TBock3185/CraftCube/Second Semester/Business Proposal/20161115_212312.jpg

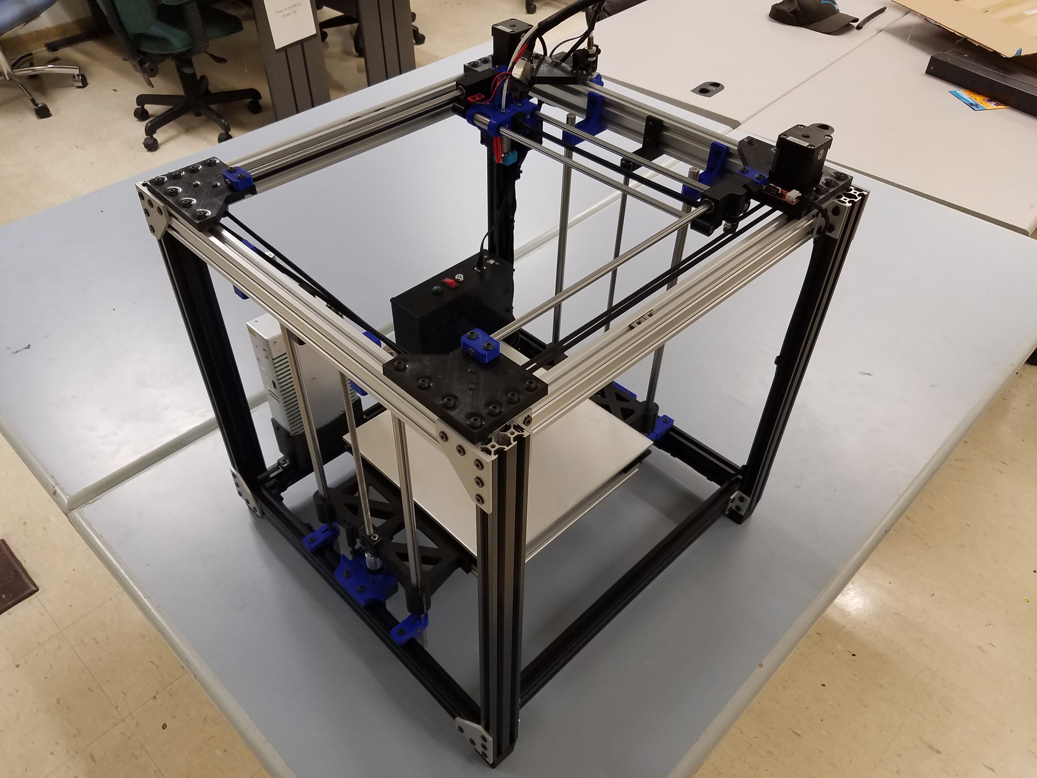
Second Semester/Business Proposal/20161115_212312.jpg
