TBock3185/CraftCube/Second Semester/193B Final Poster Draft/20161204_013916.jpg

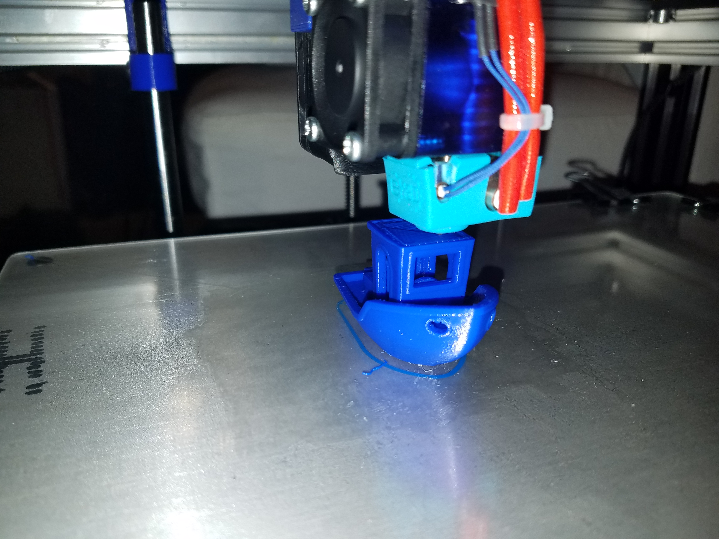
Second Semester/193B Final Poster Draft/20161204_013916.jpg
