TBock3185/CraftCube/README.md

# CraftCube
This is a repository for my  CSUS 2016 Senior Project, the Craft Cube -- CNC Laser Engraver/ 3D Printer 

Video Timelapses for Final Demonstration:

 3D Printing Timelapse: https://www.youtube.com/watch?v=elfPQdwai-g

Laser Engraving Timelapse: https://www.youtube.com/watch?v=zEBCX6oA3y4
