TBock3185/CraftCube/3D CAD Files/README.md

This readme is to note that the CAD files are incomplete because I did not include several parts:

-Pretty much all nuts & bolts

-Extruder

-Raspberry Pi Touchscreen

-Probably other stuff...

Hopefully in the coming days I will work out a BOM List.
