TBock3185/CraftCube/Second Semester/193B Final Poster Draft/193Poster_Draft _2.docx

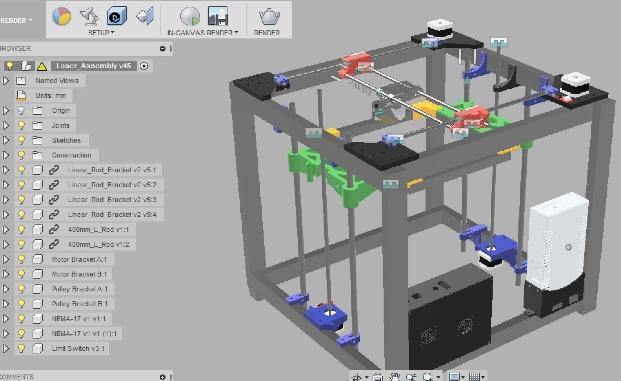
[picture p3: figure]

# Design Craft Cube Software

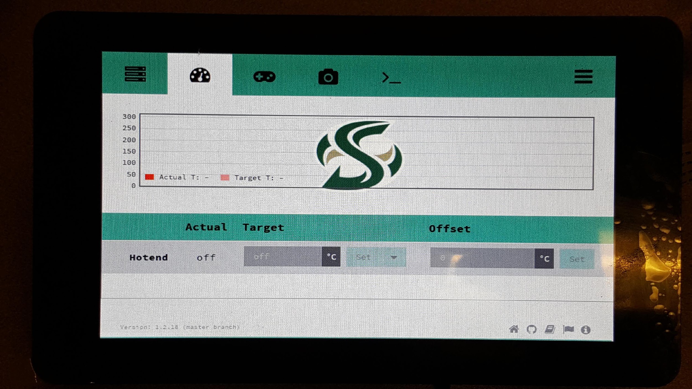
[picture p4: figure]
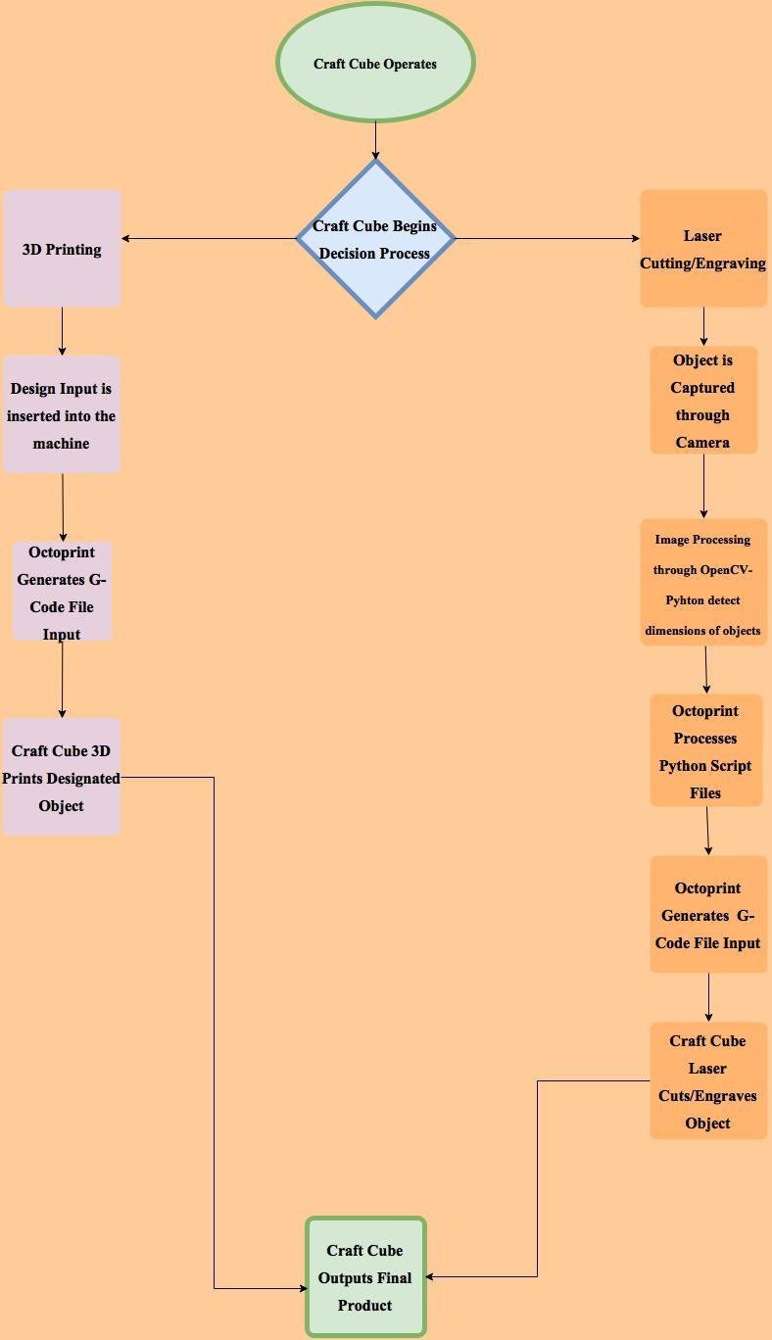
[picture p5: figure]

Craft Cube is a low cost 2 in 1 CNC machine utilizing a user-friendly operating system.

3D Model Management System

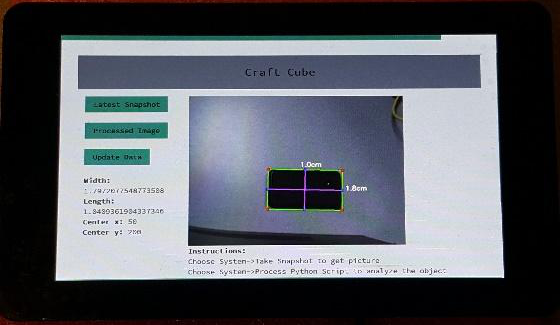
[picture p6: figure]
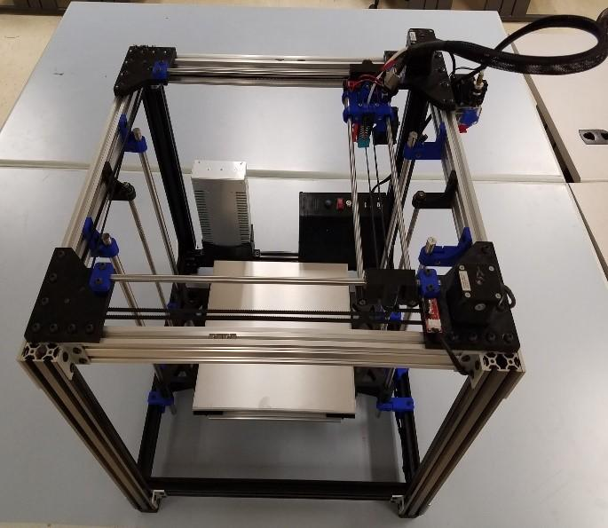
[picture p7: figure]

Flowchart

Detection Camera

CRAFT CUBE
