TBock3185/CraftCube/Second Semester/193B Final Poster Draft/V2.pptx

## Craft Cube

- 2 in 1 CNC Machine

Ammar Ahmed, Thomas Bock, Michael Gomez, Tan Hua
Electrical and Electronic Engineering, California State University Sacramento

- Hardware

Craft cube is a low cost 2 in 1 CNC Machine utilizing a user-friendly operating system. The design of the machine is constructed through 3D-Printed Parts available online. A Camera aide mounted on the end effector is used for image processing algorithm to determine the dimensions of the object.

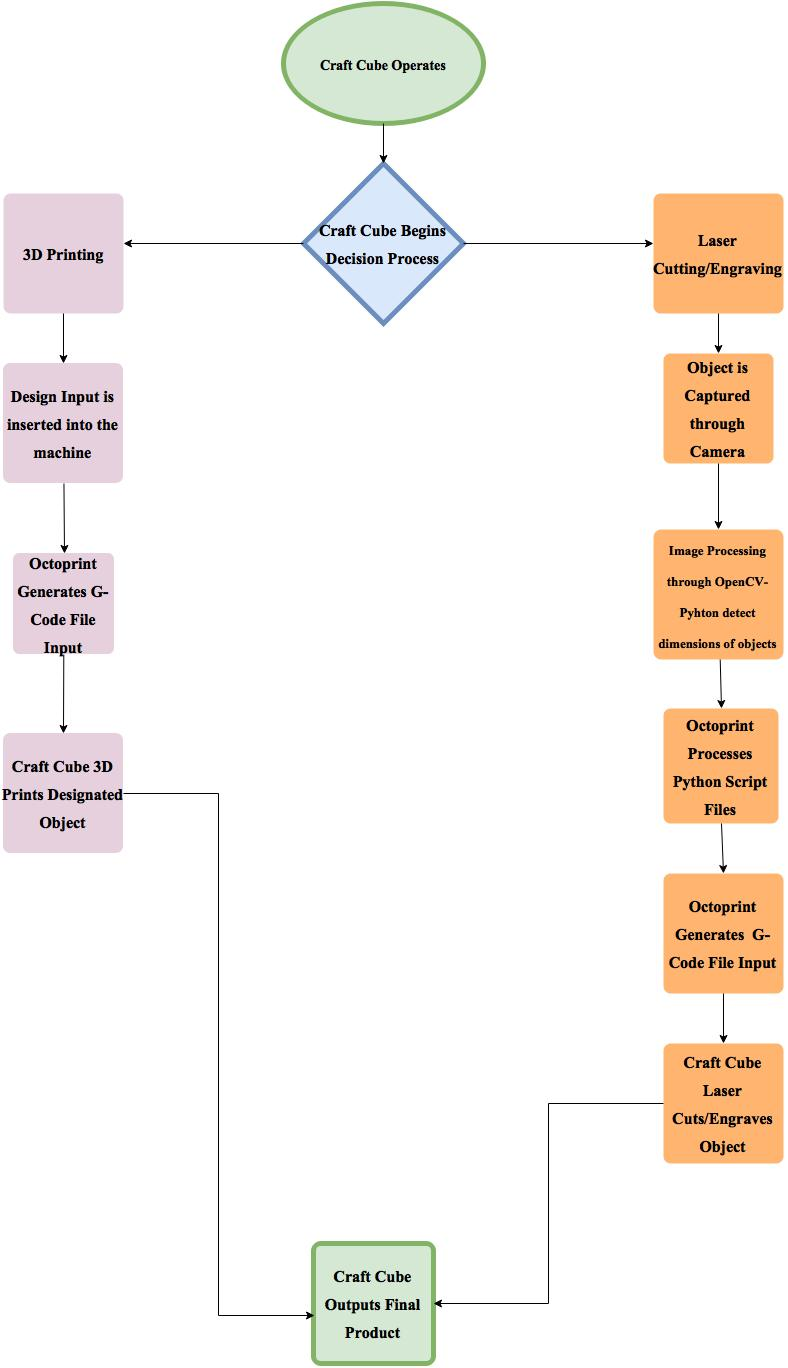
[picture p9: figure]

- 3D Model

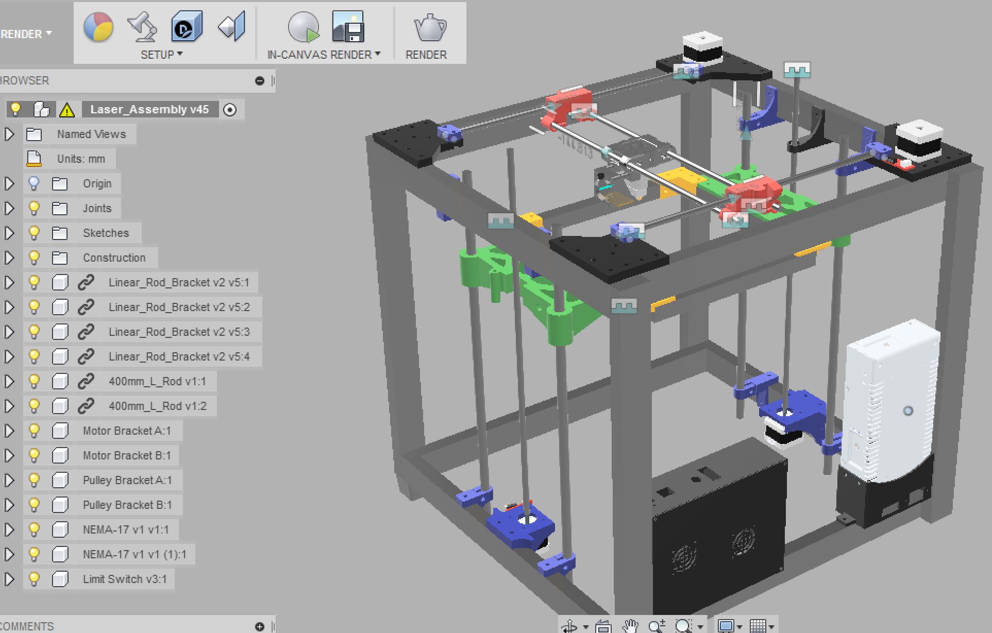
[picture p10: figure]

- 3D Print

- Hardware

Management

- Camera system

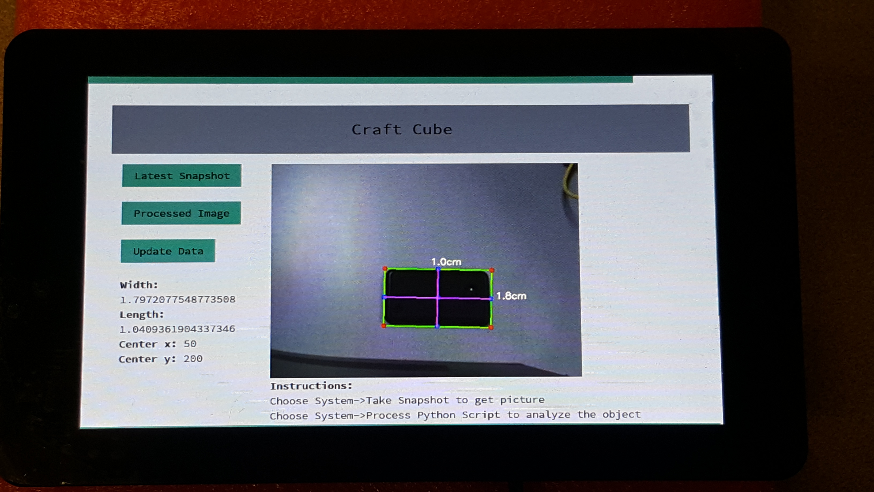
[picture p11: figure]

Laser Cutter/Engraver
