TBock3185/CraftCube/Second Semester/Business Proposal/milestone.docx

Projected Milestone

8

6

4

2

Months

Partnership

Final Version

Machine V1

Machine V2

Prototype
