TBock3185/CraftCube/Second Semester/Week 10/SeniorProjectProgress_WeeklyReport.docx

Team Members:

- Thomas Bock
- Ammar Ahmed
- Tan Hua
- Jan Michael Golez

Group Meeting Minutes:

● CNC Laser Machine Part Remodeled Version2

● Raspi Camera Image Detection

● Open CV through Python, and Octorpint Set-up

Summary of Team Tasks Assigned:

1. Housing/Ventilation System
  a. Examine Parts Needed for Ventilation System(e.g. cost of materials)
2. Stand Alone Management System(S.A.M.S.)
  a. Octoprint Troubleshooting Issues needs to be resolved
  b. Begin Testing Octoprint
3. Solitary Software System
  a. Research the necessary software package that can be read in RasPi3
  b. Understand how to connect a bridge between the software with the automated camera aspect.
4. Automated/Enhance Camera System
  a. Begin Researching on OpenCV-Python
  b. Research on different microcontrollers that is compatible with OpenCV-Python

Summary of Team Accomplishments:

1. Housing/Ventilation System
a) Parts have been examine, a group consent is required to further proceed with the materials
2. Stand Alone Management System
a) Update Raspbian to ensure Octoprint is working
b) Test and Update all software
3. Solitary Software Program
a) Python found most compatible between software, management system, and camera system
b) Begin Transcripting the language into Python
4. Automation/Enhance Camera System
a) Research on OpenCV-Python and installation of the software and libraries needed
b) Raspberry Pi3 was found to be the most compatible for making a connection between camera system and management system

Tasks Assigned for Next reporting period:

1. Housing/Ventilation System
a) Proceed discussion with parts and began redesigning enclosure/ventilation system
2. Stand Alone Management System
a) Test Octoprint with given generated Python Code
b) Have a printed structure
3. Solitary Software Program
a) Continue to transcript language into Python
b) Help with bridging management sytem, Camera, and Software
4. Automation/Enhance Camera System
a) Purchase RasPi3
b) Install OpenCV-Python in RasPi3

Issues:

1. Troubleshooting SD Card upon switching different cards

Individual Summary (cont.)

Name: Thomas Bock

Tasks Assigned for this reporting period:

1. Examine Parts Needed for Ventilation System(e.g. cost of materials)

Accomplishments this reporting period:

1. Parts Examined for enhancement of Prototype CNC Machine

Issues:

1. None

Tasks Assigned for Next reporting period:

1. First Draft Design of Ventilation/Enclosure

Individual Summary (cont.)

Name: Jan Michael Golez

Tasks Assigned for this reporting period:

1. Octoprint Troubleshooting Issues needs to be resolved

2. Test Octoprint

Accomplishments this reporting period:

1. Update Raspbian to ensure Octoprint works

2. Test and Update all software

Issues:

1. Resolving issue with Raspbian to download image.

2.

Tasks Assigned for Next reporting period:

1. Test Octoprint with given generated Python Code

2. Have a printed structure

Individual Summary (cont.)

Name: Tan Hua

Tasks Assigned for this reporting period:

1. Research the necessary software package that can be read in RasPi3
2. Understand how to connect a bridge between the software and the automated camera aspect.

Accomplishments this reporting period:

1. Python found most compatible between software, management system, and camera system
2. Begin Transcripting the language into Python

Issues:

1. None

Tasks Assigned for Next reporting period:

1. Continue to transcript language into Python
2. Help with bridging Management System, Camera, and Software

Individual Summary (cont.)

Name: Ammar Ahmed

Tasks Assigned for this reporting period:

1. Continue calibrating camera
2. Start on image processing algorithm to detect object.

Accomplishments this reporting period:

1. Camera calibration was accomplished and extrinsic and intrinsic matrix of the camera parameters has been extracted.
2. The image processing algorithm is in progress. At the mean time, the code is able to capture image, transform image into binary, and perform edge detection and some noise filtration.

Issues:

1. The extrinsic and intrinsic parameters of the camera might not be accurate. This could be resolved by mounting the camera at fixed point and taking several pictures of the checkerboard for calibration.

Tasks Assigned for Next reporting period:

1. Continue on image processing algorithm to detect object.

EEE 193B / CpE 191 Group 3S Weekly Progress Report Date: 10/31/16
