TBock3185/CraftCube/First Semester/Final Report/FinalReport.docx

California State University Sacramento

Electrical and Computer Science Department

EEE 193A/CPE 190 - Product Design Project I

Final Project Report

CNC Laser Cutter and Engraver


Team Member: Ammar Ahmed/Thomas Bock/Tan Hua/ Michael Golez

INSTRUCTOR: Suresh Vadhva

Abstract –

Keywords:

# I. Design Overview

## A. Introduction

In the industry, a widely used component for cutting and engraving materials is a CNC laser cutting machine. The machine operates by using a high-energy infra-red laser light beam. A focusing lens is attached to the laser in order to concentrate the energy into single focal point, thereby vaporizing and melting the material of interest. In order to alter the position of the laser into a desired location, a computer program known as CNC drives the positon of both the x and y axes. Asides the orientation of the axes, CNC codes can adjust the intensity of the laser to optimized the speed of the engraving or cutting of the material. Finally, by using machine vision, through the process of object orientation we can determine the position of the material. This process allows alteration of the material for better result, so that during the process the engraving or cutting is accurately done. The creation of the CNC Laser Machine will be conducted into four different parts: the mechanics between the positions of the CORE x-y axes, the laser machine circuit, CNC software for control and intensity, and finally detection system.

## B. Equipment List

A. Mechanical Parts:
  a. Stepper Motor (x2):
  b. Belts
  c. Rods
  d. 3D Printed Parts:
    i. Mounting….
B. Laser System:
  a. Laser Diode:
  b. Laser Driver:
C. Computer Vision:
  a. Web Cam (x1): Logitech C270 720p 3-MP
D. Microcontroller:
E. Arduino Shield:

## C. Team Member Summary

## D. Detailed Description

### a. Mechanics

### b. Laser System

### c. Software

### d. Computer Vision

# II. Proposals

## A. Funding Proposal

## B. Product Proposal

# III. Work Breakdown Structure (WBS)

## A. Outline of WBS

### Mechanics

### Laser System

### Software

### Computer Vision

## B. Project Timeline

### Milestone I

### Milestone II

### Milestone III

# IV. Risk Assessment

### A. Laser

### B. Mechanics

# V. User Manual

### A. Operation

- Safety considerations: Room Requirement, Objects to be cut/Engrave, Goggles

### B. Hardware Requirements

- Laptop: MATLAB, Inkscape
- Power Supply
- On/Off switch

### C. Software Requirements

- MATLAB, INKSCAPE, ReplicatorG

# VI. Design Documentation

# VII. Breakdown of Hardware Subsystems

### A. Camera

### B. Laser Diode

### C. Arduino

### D. Block diagram

# VIII. Breakdown of Software Subsystems

### A. Object Detection Algorithm

### B. Generating of G-Code

### C. Laser control

### D. Flow Chart

# IX. Mechanical Drawings and Documentation

# X. Test Plan for Hardware

# XI. Test Plan for Software

# XII. Integration Plans

# XIII. Accomplishment

# XIV. Conclusion

# XV. Appendix A: References

# XVI. Appendix B: Code

CSUS- EEE 193A/CPE 190 Final Report: CNC Laser Cutter and Engraver Ahmed/Bock/Hua/Golez
