TBock3185/CraftCube/First Semester/Week 15/SeniorProjectProgress_WeeklyReport.docx

Team Members: Thomas Bock, Ammar Ahmed, Tan Hua, Jan Michael Golez

Group Meeting Minutes:

- Testing CNC Laser.
- Attach Camera
- Complete Software Integration
- Documentation Discussed
- Assign parts that are towards each member
- Talk For Future Plans toward the project

Summary of Team Tasks Assigned:

1. Mechanics
a. Attach LED on rail boards.
2. Laser Diode
  a. Continue Documentation
3. Software
a. Begin Documentation.
4. Computer Vision
  a. Work on algorithm for edge detection( needed for dimension detection)

Summary of Team Accomplishments:

1. Mechanics
a. Camera System Attached
2. Laser Diode
a. Attach LEDS on the CNC laser to remove shadow effects.
b. Continue Documentation
3. Software
a. Rasterizing works 25%.
4. Computer Vision
a. An algorithm was found for filling circular objects but still working on the drawing box around the detected object.

Tasks Assigned for Next reporting period:

1. Mechanics
  a. Ensure that the device is Functional
  b. Begin Documentation
2. Laser Diode
a. Extend Wire connection for LEDS.
3. Software
a. Continue documentation.
b. First Draft Done
4. Computer Vision
  a. Resolve the issue by finding the algorithm for filling the gaps or drawing a box around the detected object

Issues:

1. Test Laser was misplaced or lost, discussion whether new laser will be bought or detaching the laser from the project itself.
2. None

Individual Summary (cont.)

Name: Thomas Bock

Tasks Assigned for this reporting period:

1. Attach LED on rail boards.

Accomplishments this reporting period:

1. Camera System Attached .

Issues:

1. Rasterizing works only a portion of the time.

Tasks Assigned for Next reporting period:

1. Ensure that the device is Functional
2. Begin Documentation

Individual Summary (cont.)

Name: Jan Michael Golez

Tasks Assigned for this reporting period:

1. Continue Documentation

Accomplishments this reporting period:

1. Attach LEDS on the CNC laser to remove shadow effects.
2. Continue Documentation

Issues:

1. None

Tasks Assigned for Next reporting period:

1. Extend Wire connection for LEDS.

Individual Summary (cont.)

Name: Tan Hua

Tasks Assigned for this reporting period:

1. Begin Documentation

Accomplishments this reporting period:

1. Rasterizing works 25%.

Issues:

1. Rasterizing works only a portion of the time.

Tasks Assigned for Next reporting period:

1. Continue documentation.
2. First Draft Done

Individual Summary (cont.)

Name: Ammar Ahmed

Tasks Assigned for this reporting period:

1. Finishing up with documentation
2. Preparing final presentation slides

Accomplishments this reporting period:

1. Documentation started and on progress
2. Presentation Slides almost done

Issues:

1. No issues found

Tasks Assigned for Next reporting period:

1. Finishing up with documentation
2. Preparing final presentation slides

EEE 193A / CpE 190 Group 3S Weekly Progress Report Date: 5/9/16
