TBock3185/CraftCube/First Semester/Week 10/EEE 193A Design Review.docx

CNC Laser Cutting Machine

Ammar Ahmed, Thomas Bock, Tan Hua and Michael Golez
California State University, Sacramento

EEE-193A/CPE 190
2330-2016

Abstract –

# I. Introduction

In the industry, a widely used component for cutting and engraving materials is a CNC laser cutting machine. The machine operates by using a high-energy infra-red laser light beam. A focusing lens is attached to the laser in order to concentrate the energy into single focal point, thereby vaporizing and melting the material of interest. In order to alter the position of the laser into a desired location, a mechanic of motion known as CORE X-Y drives the positon of both the x and y axes. By rotating both stepper motors in different directions the position of the horizontal bar can shift between left and right, and opposite direction drives the machine up and down. In order to detect the dimensions of the object for better precision a camera is mounted on the CNC to accurately engrave and cut the desired material. These specific features of the CNC Laser Machine will then be controlled by a single microcontroller which provides a command for the whole system. The implementation of this project will be divided into three different parts: Rough Draft Design, Design Construction, and finally Design Testing/Debugging.

# II. Design Draft

  A. Brainstorming
  B. Operational Chart
  C. Project Breakdown/TimeLine
  D. Material Costs

# III. Design Construction

A. Mechanics (Core X-Y Axes)
B. Hardware (Laser Diode)
C. Software (CNC/Microcontroller Implementation)
D. Software (Computer Vision System)

# IV. Design testing/debugging

A. Mechanics (Core X-Y axes)
B. Hardware (Laser Diode)
C. Software (CNC/Microcontroller Implementation)
D. Software (Computer Vision System)

# V. Risk Assessment

A. Mechanics (Core X-Y axes)
B. Hardware (Laser Diode)
C. Software (CNC/Microcontroller Implementation)
D. Software (Computer Machine Vision)

# References

[1] http://www.hydram.co.uk/technical/laser-cutting-tech/
