TBock3185/CraftCube/First Semester/Week 7/Copy of SeniorProjectProgress_WeeklyReport.doc.docx.docx

Team Members: Thomas Bock, Ammar Ahmed, Tan Hua, Yan Michael Golez

Group Meeting Minutes:

- Techniques for getting dimensions from an image (Edge Detection)
- Revision of WBS
- Updating Gantt Chart
- 3-D printed mechanical parts
- Ordering Panel
- Core X-Y Assemble
- Testing Implementation of the Laser
- Functionality of the multiple stepper motors
- G-code instruction to stepper motors
- Platforms choice
- Plans for next week

Summary of Team Tasks Assigned:

1. Mechanics
  a. Order?Receive Panels
  b. 3D Print remaining Parts
  c. Assemble XY Platforms
  d. Testing of components
2. Laser Diode
  a. PWM implementation on the laser driver
  b. Testing of the CNC Laser
3. Software
  a. Stepper Motors manage to move G-Code instructions
  b. Complete Software structure with tools and programs
  c. Ensuring the stepper motors working on multiple platforms
4. Computer Vision
  a. Work on algorithm for edge detection( needed for dimension detection)

Summary of Team Accomplishments:

1. Mechanics
a) Panel is in progress of delivery
b) 3D Printing Parts are obtained
c) Core X-Y platform is in progress of being assembled
2. Laser Diode
a) Power Supply Was used effectively
b) Testing of 445nm 2W laser diode
c) Output power of 2W on the Blue Laser Diode
3. Software
a) Stepper motor was able to run individually
b) Complete structures is the combination between Marlin and Ramp 1.4
c) Stepper Motor can run on zeroPi and Arduino Mega 2560
4. Computer Vision
a) The algorithm for edge detection was accomplished

Tasks Assigned for Next reporting period:

1. Mechanics
  a. Order/Receive Panel
  b. 3-D Print Remaining Parts
  c. Assemble X-Y Platform
  d. Begin testing
2. Laser Diode
  a. PWM implementation on the laser driver
  b. Testing of the PWM in conjunction with the laser driver
3. Software
  a. Stepper motors work simultaneously
  b. Resolve the conflicts between program versions
  c. Perform a complete process from design to execution
4. Computer Vision
  a. Resolve the issue by finding the algorithm for filling the gaps or drawing a box around the detected object

Issues:

1. Adjustments to the final CAD model changed position of several mounting holes for main panel. Therefore panel still hasn’t been ordered. With final model completed, panel can now be ordered
2. First set of 3D printed parts were undersized and have to be remade. The CAD model did not account for tolerance when 3D printing the parts
3. The compatibility between the ZeroPi board and latest Arduino IDE
4. The testing workspace was not built because the algorithm has to be completed first. It is also necessary to carry a camera on the backpack than carrying the workspace at this stage of the project

Individual Summary (cont.)

Name: Thomas Bock

Tasks Assigned for this reporting period:

1. Order/Receive Panel
2. 3D Printing Remaining Parts
3. Assemble XY Platforms
4. Testing

Accomplishments this reporting period:

1. Panel is in progress of delivery
2. 3D Printing Parts are obtained
3. Core X-Y platform in in progress of being assembled

Issues:

1. It is cost prohibitive to order a panel of that size for machining. So a new panel style that can be broken up into pieces will need to be designed
2. I have been gone in Texas for most of the work time this week, therefore no testing was done
3. A revision to the 3d printed carriage pieces has been made to make them smaller, weigh less, and be easier to print. Due to this the pieces need to be reprinted

Tasks Assigned for Next reporting period:

1. Integration
2. Design of Laser Housing

Individual Summary (cont.)

Name: Jan Michael Golez

Tasks Assigned for this reporting period:

1. PWM implementation on the laser driver.
2. Prototype Laser Diode: Regulate the current current for functionality.
3. Testing of the CNC Laser

Accomplishments this reporting period:

1. Understand how to use the power supply effectively
2. Began testing the 2W 445nm Blue Laser Diode in conjunction with a DC Regulated Power Supply(HY3003D/HY3005D) .
3. The Laser Diode was able to output 2W by having an output current of 1A with 2V.

Issues:

1. Implementation of the PWM module was not accomplished. More research is needed
2. Need Research done on the Laser Driver and Laser Diode to further verify the intensity and power of the Laser Diode.

Tasks Assigned for Next reporting period:

1. PWM implementation on the laser driver
2. Testing of the PWM in conjunction with the laser driver

Individual Summary (cont.)

Name: Tan Hua

Tasks Assigned for this reporting period:

1. Stepper motors manage to move as G-code instructions
2. Complete software structure with tools and programs
3. Ensuring the stepper motors working on multiple platforms

Accomplishments this reporting period:

1. Stepper motor was able to run individually
2. Software structure is the combination between Marlin and Ramp 1.4
3. Stepper motor can run on zeroPi and Arduino Mega 2560

Issues:

1. The stepper motor was still not fully following g-code instruction
2. G-code generator didn’t work sometimes due to the connection.
3. Switching between Mac and Windows causes the conflicts between the programs.

Tasks Assigned for Next reporting period:

1. Stepper motors work simultaneously
2. Resolve the conflicts between program versions
3. Perform a complete process from design to execution

Individual Summary (cont.)

Name: Ammar Ahmed

Tasks Assigned for this reporting period:

1. Work on the algorithm for edge detection (needed for dimension detection)

Accomplishments this reporting period:

1. The algorithm for edge detection was accomplished.

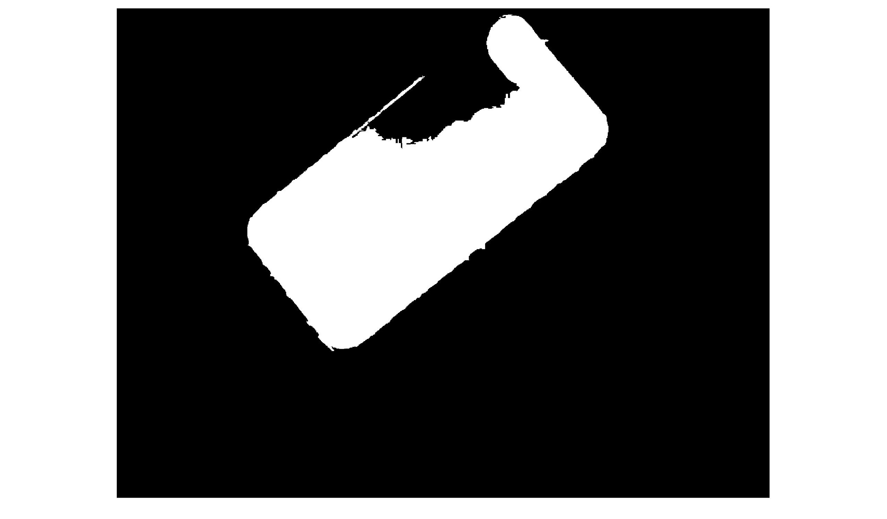
[picture p62: figure]

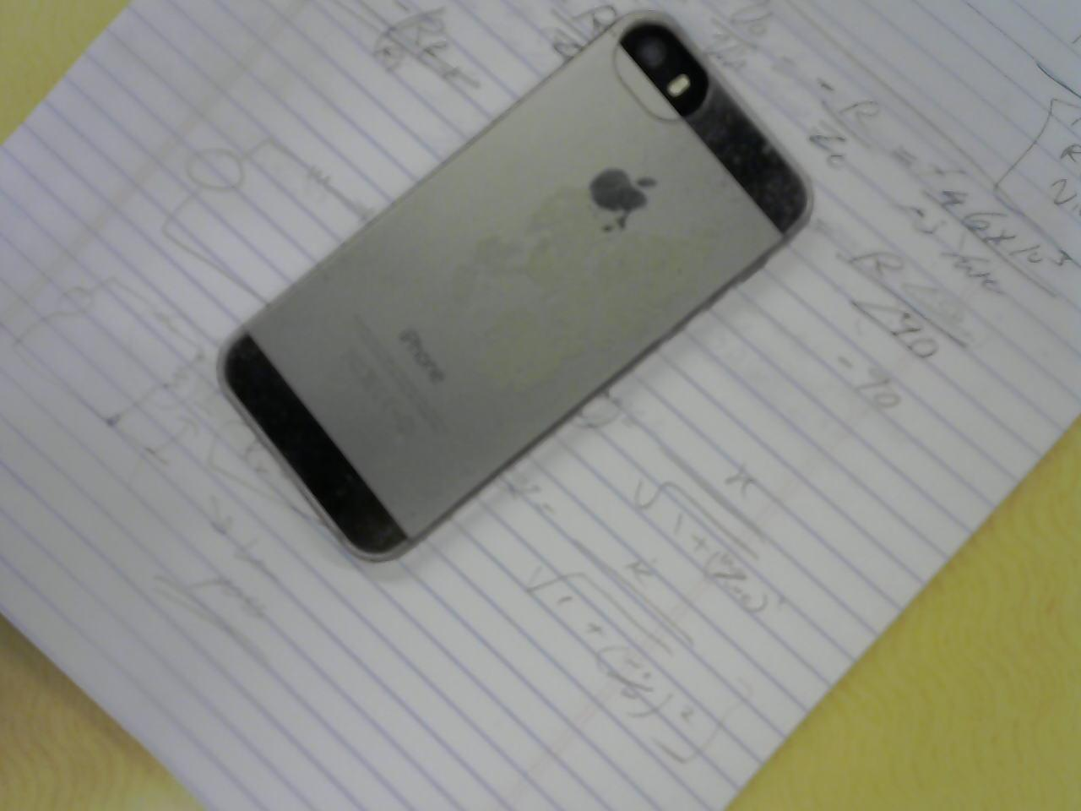
[picture p63: figure]
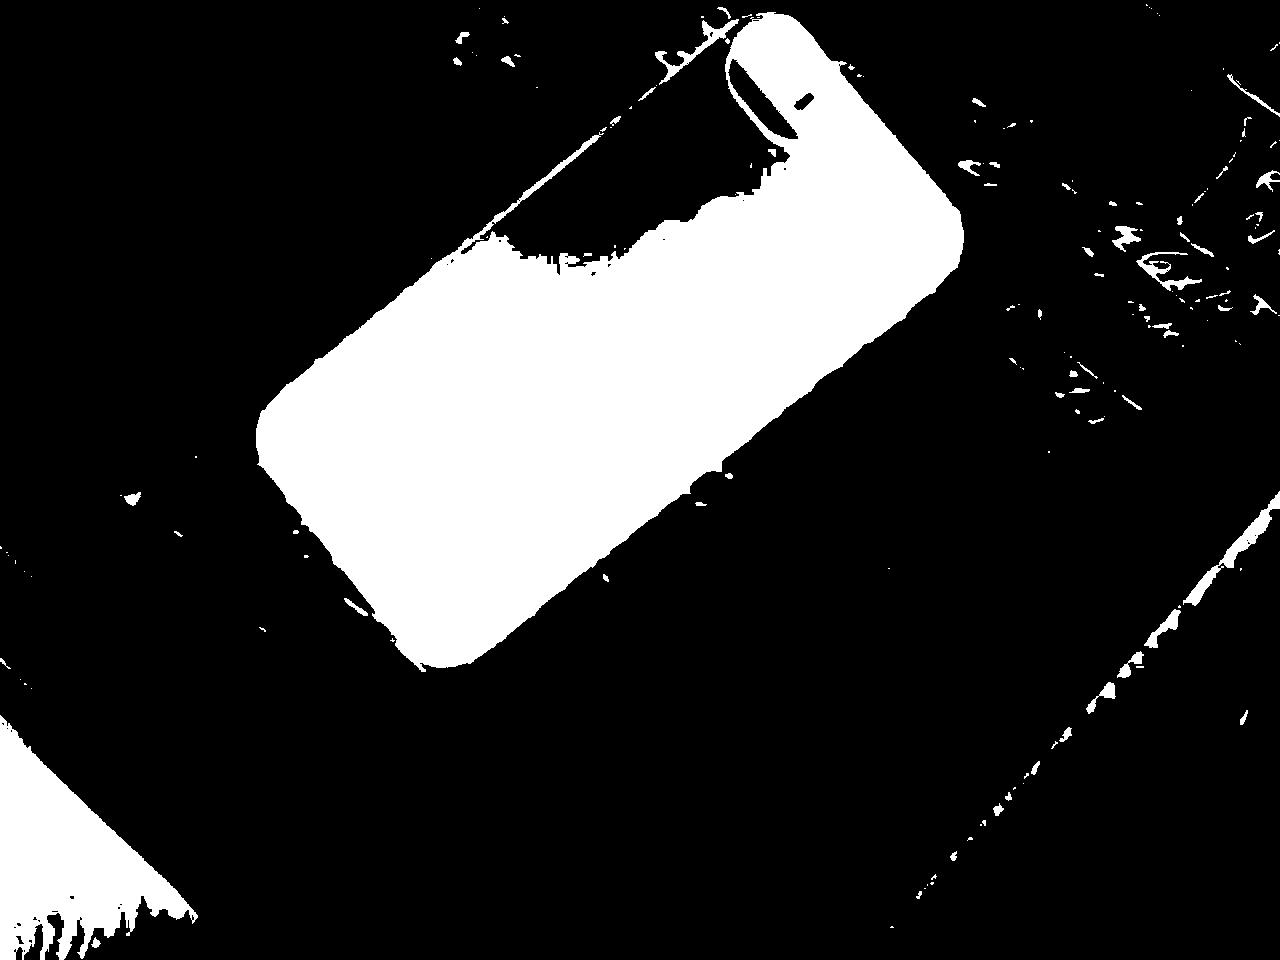
[picture p64: figure]
BW

Issues:

1. Light can cause an issues on the image processing. As it can be seen from the pictures, the original image was converted to binary and there was noise in the picture (second picture). After filtering out the noise in the picture, some of boundaries of the phone were gone because of the resolution of the image which could also a light issue.
2. There were gaps in the detected object.

Tasks Assigned for Next reporting period:

1. Resolve the issues by finding algorithms for filling the gaps or drawing a box around the detected object.

EEE 193A / CpE 190 Group 3S Weekly Progress Report Date: 3/7/16
