TBock3185/CraftCube/Second Semester/Week 3/WBS_193B_Fall2016.docx

CNC Laser Machine
Housing & Ventilation System (Thomas Bock)
Research on Fans & Filters
Research on capabilites of RasPi3
Continue Research on filtration/housing
Automation/Improvement of Camera System(Ammar Ahmed)
CAD Design Draft#1
CAD Design Draft#2
Final CAD Design
Purchase/Obtain Printing Parts
Assemble Printed parts
Final Assembly
CNC Machine Integration
Testing of Integrated Machine
Stand Alone Management System(Michael Golez)
Continue researching capabilities of integration between softwares
Research compatibility of Python on RasPi3
All In One Software Program(Tan Hua)
Ensure compatability/continue reasearch on Python
Obtain Necessary Hardware (RasPi3 & LCD Screen)
Assemble Management System
Test Management System
CNC Machine Integration
Testing of Integrated Machine
Final Assembly
Research on Software package
Continue Research on software package
Transcript language into Python
Continue to transcript language into Python
G-code generation for Laser Cutting
G-code generation for Laser Engraving
Test Software System
Testing of Integrated Machine
Final Assembly
Research on OpenCV using Python
Continue with OpenCV using Python
Familiarize on using Python
Improve on using Python on OpenCV
Begin Camera Calibration
Modify Software to Python on the CNC Machine Laser
Test Camera System
Testing of Integrated Machine
Final Assembly
