TBock3185/CraftCube/First Semester/Week 6/Week 6 log.docx

Date and Time:

Location:

Who: Tan

Accomplishments:

http://www.instructables.com/id/MicroSlice-A-tiny-Arduino-laser-cutter/?ALLSTEPS

https://github.com/grbl/grbl/wiki/Connecting-Grbl

http://zapmaker.org/projects/grbl-controller-3-0/

Flashing Grbl to the Arduino

https://github.com/grbl/grbl/wiki/Flashing-Grbl-to-an-Arduino

Running grbl controller on raspberry pi

http://zapmaker.org/raspberry-pi/running-grbl-controller-on-raspberry-pi/

Stuck in the codes, check the websites of zero pi and they said they are preparing new documentations for the board.
