TBock3185/CraftCube/First Semester/Week 4/EEE 193A_Porposal.docx

CNC Laser Cutting Machine

Ammar Ahmed, Thomas Bock, Tan Hua and Michael Golez
California State University, Sacramento

EEE-193A/CPE 190
2-10-2016

# I. Introduction

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

# II. Construction

  A. CORE x-y axes

The laser tool head will be mounted in movement platform built following the Core X-Y movement theory. Core X-Y is a derivative of the Cartesian movement theory where the axes of movement are rotated 45 degrees from the X and Y axes. This allows for minimizing backlash and maximizing precision while only slightly adding to the complexity of the design.

The motion platform will consist of two stepper motors, several linear rods, linear bearings, belt runs, and pulleys. These will be attached to a main gantry plate, made of aluminum or similar material, which will be CNC machined for precise mounting of all of the components. Our main goal for the size of the gantry would allow the dimensions of the build area to support an A4 sized sheet of paper.

  B. Laser Cutter

Laser Operational Function.

The laser cutter will operate through the combination of a laser diode driver and laser diode. By combining both systems the driver will produce a constant regulated voltage and current that will be driven to the load. By simply altering the value of the PWM the user can modify the voltage and current being outputted towards the diode.

Risk Management

To minimize risks, certain components will be attached to the circuit. A heatsink device will be attached to the laser to regulate the temperature of the driver. Then safety goggles are worn by the user to prevent the laser from impeding their vision. There will be a shroud or enclosure for the laser to minimize risk to bystanders

  C. CNC software

Creating the products from the CNC laser cutting machine is a 3-phase process. Starting from the user’s design on CAD (Computer Aided Design) tools, which define the dimensions and final design of the product before the execution. The next phase is CAM (Computer Aided Manufacturing) process, where the design created from CAD will be translated into the last phase of the process, G-code. G-code is the numerical control programming language to control the laser functions, such as movement, laser information, types of shapes, coordinated system.

  D. Detection System

Computer vision ‘C.V’ system will be used to identify the working space of the machine. A camera will be placed on top and parallel to the working space. The camera will take a picture of the object that will be cut and send the picture to the microcontroller or Raspberry Pi (to be determined). The open CV along with the algorithm (triangle similarity technique) will be used to determine the dimension of the object. Based on the dimension, the microcontroller will be updated so that the cutting process stays within the working space.

# III. Functional Operation Flowchart

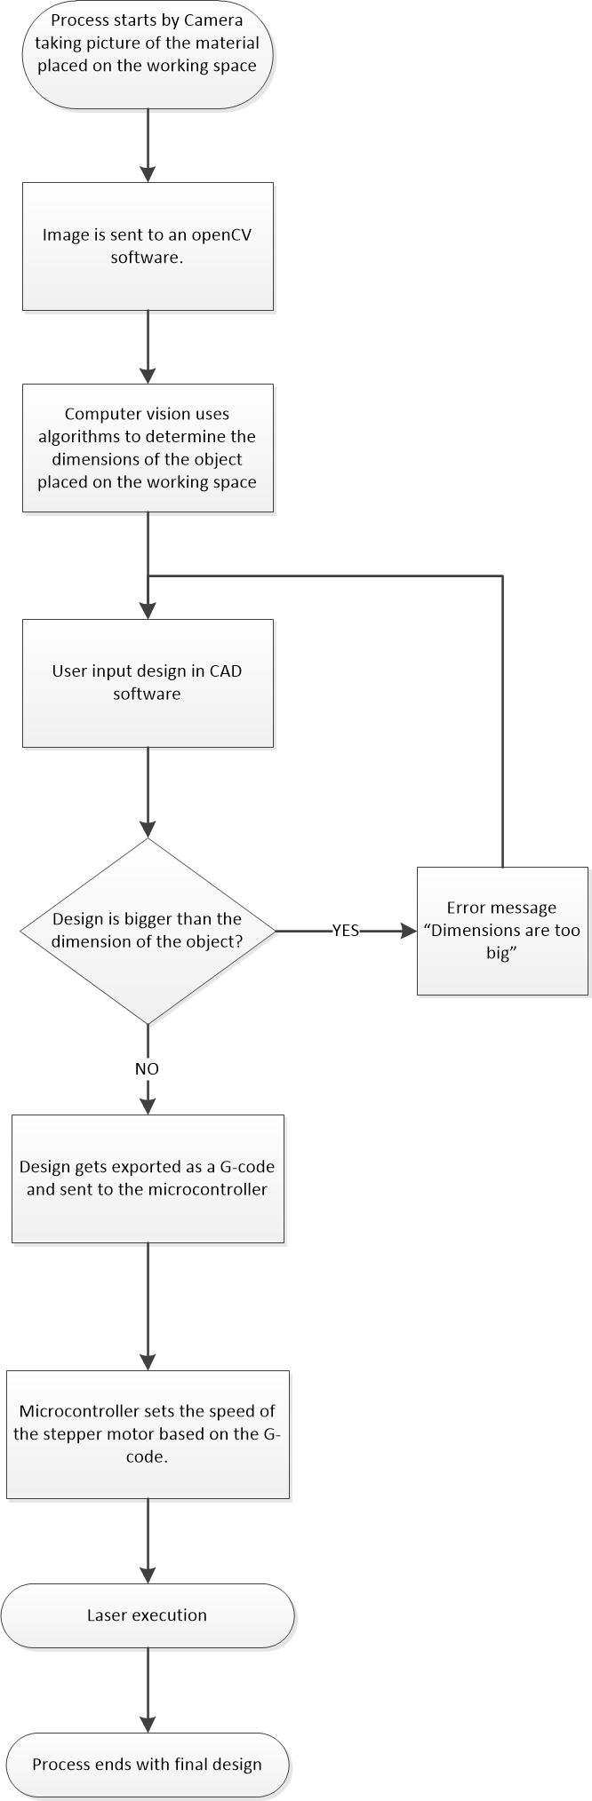
[picture p66: figure]
