TBock3185/CraftCube/First Semester/Week 4/Untitled document.docx

http://www.instructables.com/id/MicroSlice-A-tiny-Arduino-laser-cutter/?ALLSTEPS

http://www.instructables.com/id/Arduino-Laser-Engraver/?ALLSTEPS
