TBock3185/CraftCube/First Semester/Week 3/EEE 193A.docx

CNC Laser Cutting Machine

Ammar Ahmed, Thomas Bock, Tan Hua and Michael Golez
California State University, Sacramento

EEE-193A/CPE 190
2-10-2016

Abstract –

# I. Introduction

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

# II. Construction

  A. CORE x-y axes

Design Implementation

CORE X-Y motion

  B. Laser Cutter
I. Laser Operational Function.

A laser cutter operates by using a parallel beam of light consisting of a specific wavelength color, through a laser tube. By inserting an optical lens through the laser tube, the laser can be controlled to intensify the cutting and engraving. By using a microcontroller the pointer will move according to defined input file of a drawing. This can then be used to determine to whether the material is set up for engraving or cutting.

II. Risk Management

Because lasers are highly dangerous certain health and safety regulations are attached towards the tube to prevent casualties. The tube will be connected with exhausters to regulate the fumes and toxic vapors generated by the laser. During operation hours the laser can reach high temperatures, as a result a cooling for the test tube is attached. Lastly, laser goggles are essential to prevent the ranges of the wavelength of the laser. This ensures that the person who uses the laser will not be blinded caused by the laser tube.

  C. CNC software

Interpretation of G-Code to translation into motion

Understanding/ creating the algorithm behind the intensity and motion of the CNC laser

  D. Computer Vision System

Computer vision ‘C.V’ system will be used to identify the working space of the machine. A camera will be placed on top and parallel to the working space. The camera will take a picture of the object that will be cut and send the picture to the microcontroller or Raspberry Pi (to be determined). The open CV along with the algorithm (triangle similarity technique) will be used to determine the dimension of the object. Based on the dimension, the microcontroller will be updated so that the cutting process stays within the working space.

# III. Hardware Block Diagram

# IV. Functional Operation Flowchart

# V. System Modeling

Now we want to be able to model the system so that others

# References

[1] http://www.hydram.co.uk/technical/laser-cutting-tech/
