TBock3185/CraftCube/First Semester/Final presentation/Charts-Diagram/BlockDiagram_FinalPresentation.docx

Camera

Laser

Stepper Motors

Laser Driver

Motor Shield

Microcontroller

Computer
