TBock3185/CraftCube/First Semester/Final presentation/Charts-Diagram/FlowChart_FinalPresentation.docx

Laser/Engraver Product

(Repetier)

Regulates Laser Intensity

(Repetier)

Controls Motion of Motors

Data stored as Table of columns and Row

Camera System detects object dimension

Start

(Results from camera

are input manually

into software)

Repetier

(Executes G-Code)

User Design Input Processed

Inkscape Generates G-Code

(Inkscape)
