TBock3185/CraftCube/First Semester/Week 4/Flowchart (proposal).pdf

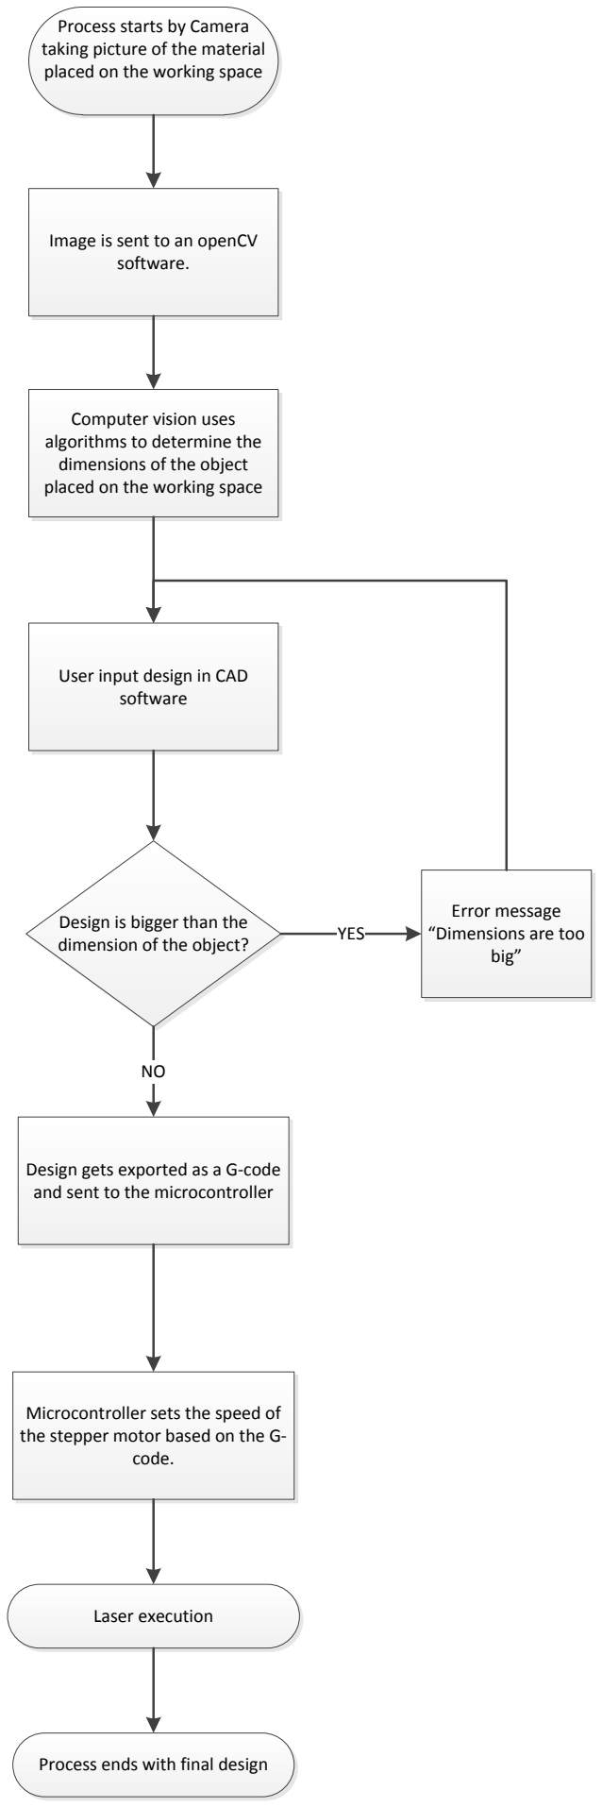
[picture p68: figure]
placed on the working space; Microcontroller sets the speed of the stepper motor based on the G- code.; Image is sent to an openCV software.; User input design in CAD software

Process starts by Camera taking picture of the material

Design gets exported as a G-code and sent to the microcontroller

Computer vision uses algorithms to determine the dimensions of the object

Design is bigger than the dimension of the object?

Error message “Dimensions are too big” YES

Laser execution Process ends with final design
