TBock3185/CraftCube/First Semester/Week 13/WBS(Update _4_20_16).pdf

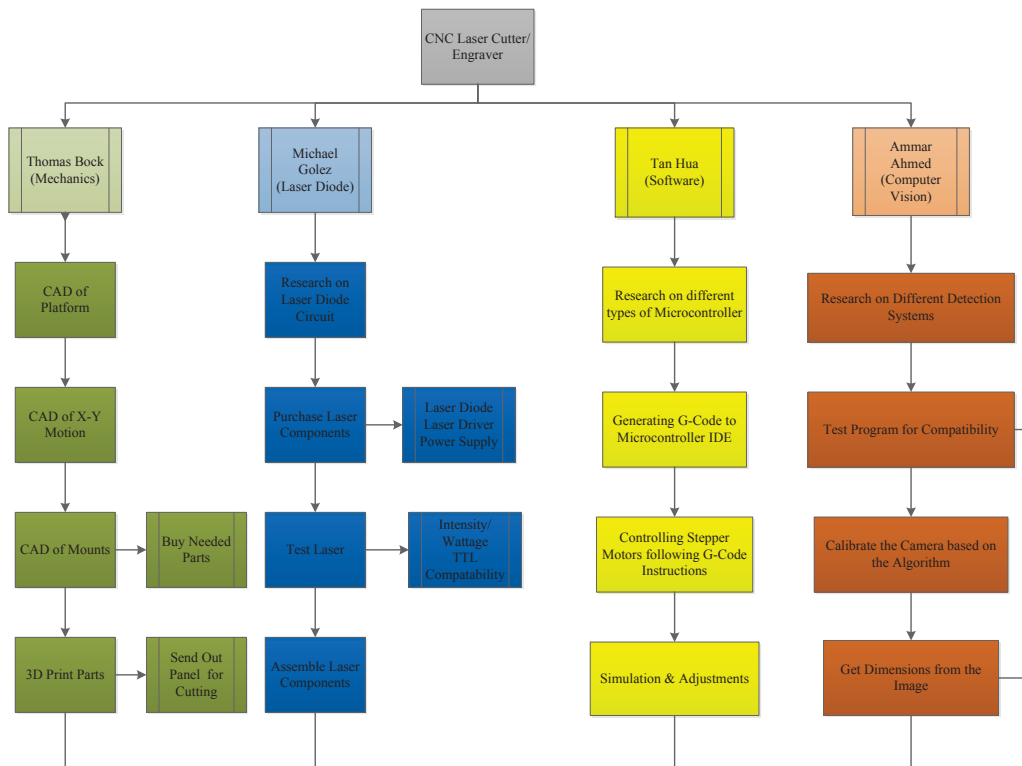
[picture p95: page 1]
Thomas Bock (Mechanics); Michael Golez (Laser Diode); Tan Hua (Software); Ammar Ahmed (Computer Vision); CAD of Platform; CAD of X-Y Motion; 3D Print Parts; Send Out Panel for Cutting; Buy Needed Parts; Research on Laser Diode Circuit; Purchase Laser Components; Laser Diode Laser Driver Power Supply; Test Laser; Intensity/ Wattage TTL Compatability; Assemble Laser Components; Instructions; Simulation & Adjustments; Systems; the Algorithm; Image

CNC Laser Cutter/
Engraver

Research on different
types of Microcontroller

Research on Different Detection

Generating G-Code to
Microcontroller IDE

Test Program for Compatibility

Controlling Stepper
Motors following G-Code

Calibrate the Camera based on

CAD of Mounts

Get Dimensions from the

Work on
Algorithm
(Edge Detection)

Understand
Watershed
Algorithm
he | Export data on text/Excel file

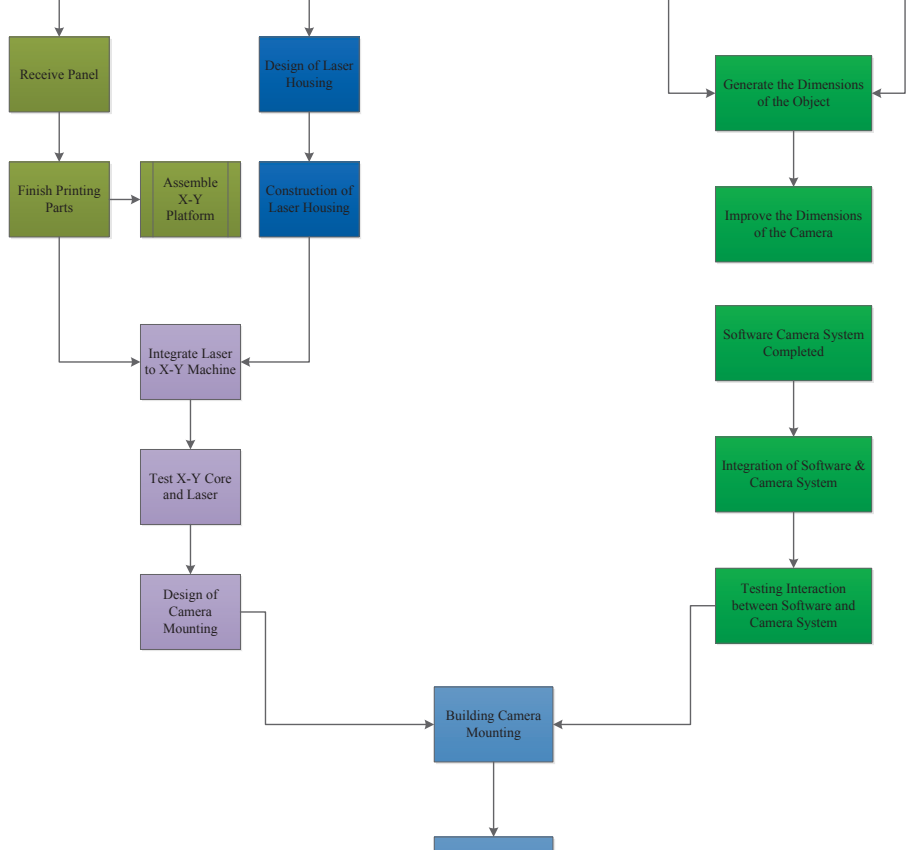
[picture p96: page 3]
Receive Panel; Finish Printing Parts; Assemble X-Y Platform; Construction of Laser Housing; Integrate Laser to X-Y Machine; Test X-Y Core and Laser; Design of Camera Mounting; Completed; Building Camera Mounting

Design of Laser
Housing

Generate the Dimensions
of the Object

Improve the Dimensions
of the Camera

Software Camera System

Integration of Software &
Camera System

Testing Interaction
between Software and

Testing the CNC
Laser System

Final Laser System
Constructed
