TBock3185/CraftCube/First Semester/Week 6/WBS(Update _2_29_16).pdf

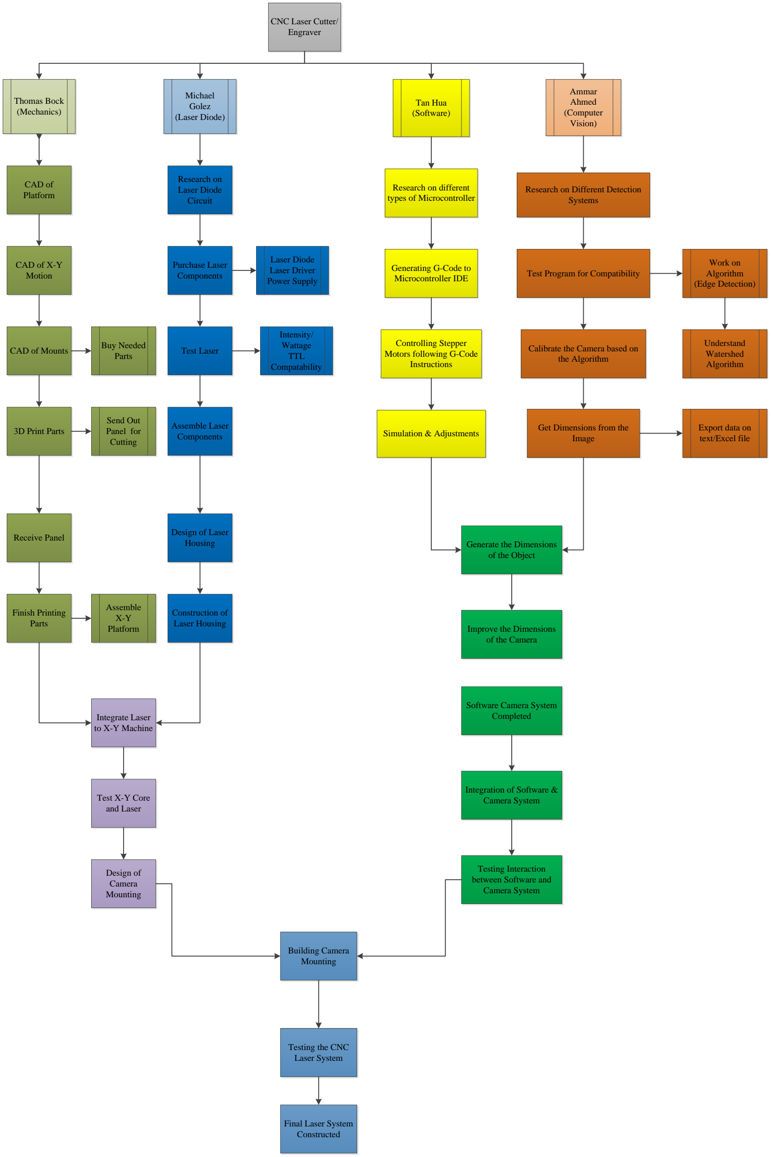
[picture p97: figure]
CNC Laser Cutter/ Engraver; Thomas Bock (Mechanics); Michael Golez (Laser Diode); Tan Hua (Software); Ammar Ahmed (Computer Vision); CAD of Platform; CAD of X-Y Motion; CAD of Mounts; 3D Print Parts; Send Out Panel for Cutting; Buy Needed Parts; Receive Panel; Finish Printing Parts; Assemble X-Y Platform; Research on Laser Diode Circuit; Purchase Laser Components; Laser Diode Laser Driver Power Supply; Test Laser; Intensity/ Wattage TTL Compatability; Assemble Laser Components; Design of Laser Housing; Construction of Laser Housing; Integrate Laser to X-Y Machine; Test X-Y Core and Laser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
