TBock3185/CraftCube/First Semester/Week 4/WBS(updated).pdf

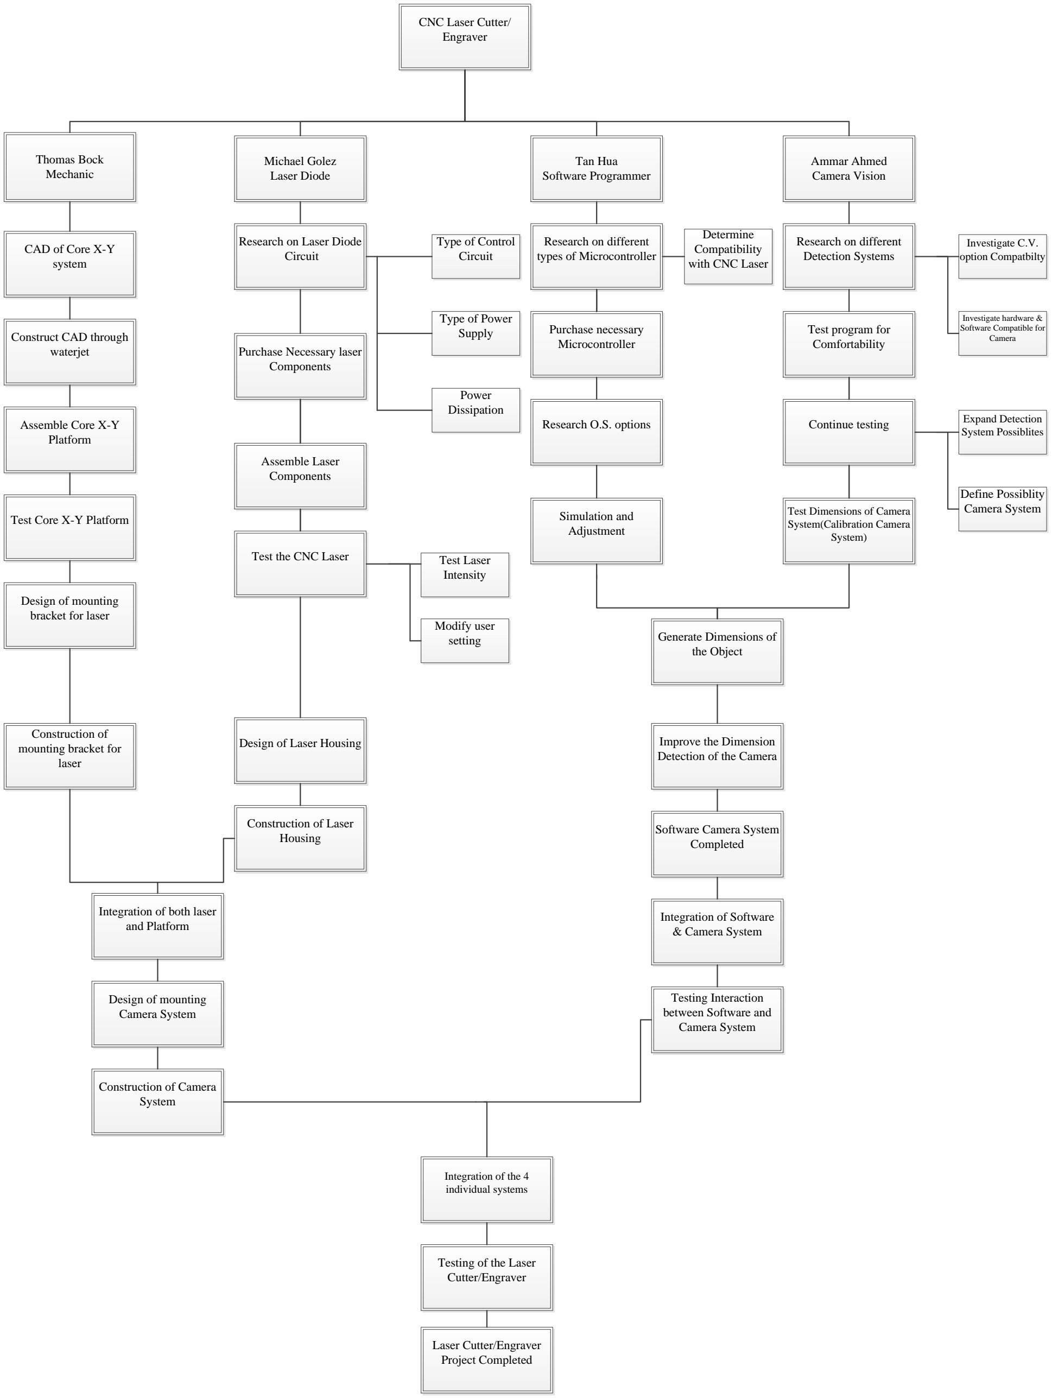
[picture p98: figure]
CNC Laser Cutter/ Engraver; Thomas Bock Mechanic; Michael Golez Laser Diode; Tan Hua Software Programmer; Ammar Ahmed Camera Vision; CAD of Core X-Y system; Construct CAD through waterjet; Assemble Core X-Y Platform; Test Core X-Y Platform; Design of mounting bracket for laser; Construction of mounting bracket for laser; Integration of the 4 individual systems Testing of the Laser; Cutter/Engraver; Laser Cutter/Engraver Project Completed; Research on Laser Diode Circuit; Type of Control Circuit; Type of Power Supply; Power Dissipation; Purchase Necessary laser Components; Assemble Laser Components; Test the CNC Laser; Test Laser; Intensity; Modify user setting; Design of Laser Housing; Construction of Laser Housing; Integration of both laser and Platform; Design of mounting Camera System; Construction of Camera System; Research on different types of Microcontroller; Determine Compatibility with CNC Laser; Purchase necessary Microcontroller; Research O.S. options; Simulation and Adjustment; Research on different Detection Systems; Investigate C.V. option Compatbilty; Investigate hardware &; Comfortability; Continue testing; Test Dimensions of Camera; Camera System; System(Calibration Camera System); Generate Dimensions of the Object; Improve the Dimension Detection of the Camera; Software Camera System Completed; Integration of Software & Camera System; Testing Interaction between Software and Camera System

Software Compatible for Camera Test program for

Expand Detection System Possiblites Define Possiblity
