TBock3185/CraftCube/Second Semester/193B Final Poster Draft/193Poster_Draft _2(1).docx

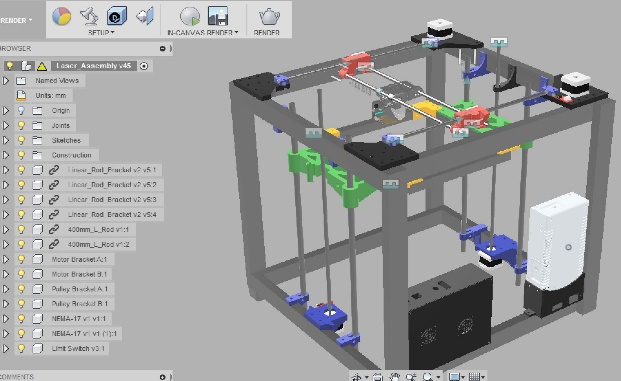
[picture p139: figure]

# Design Craft Cube Software

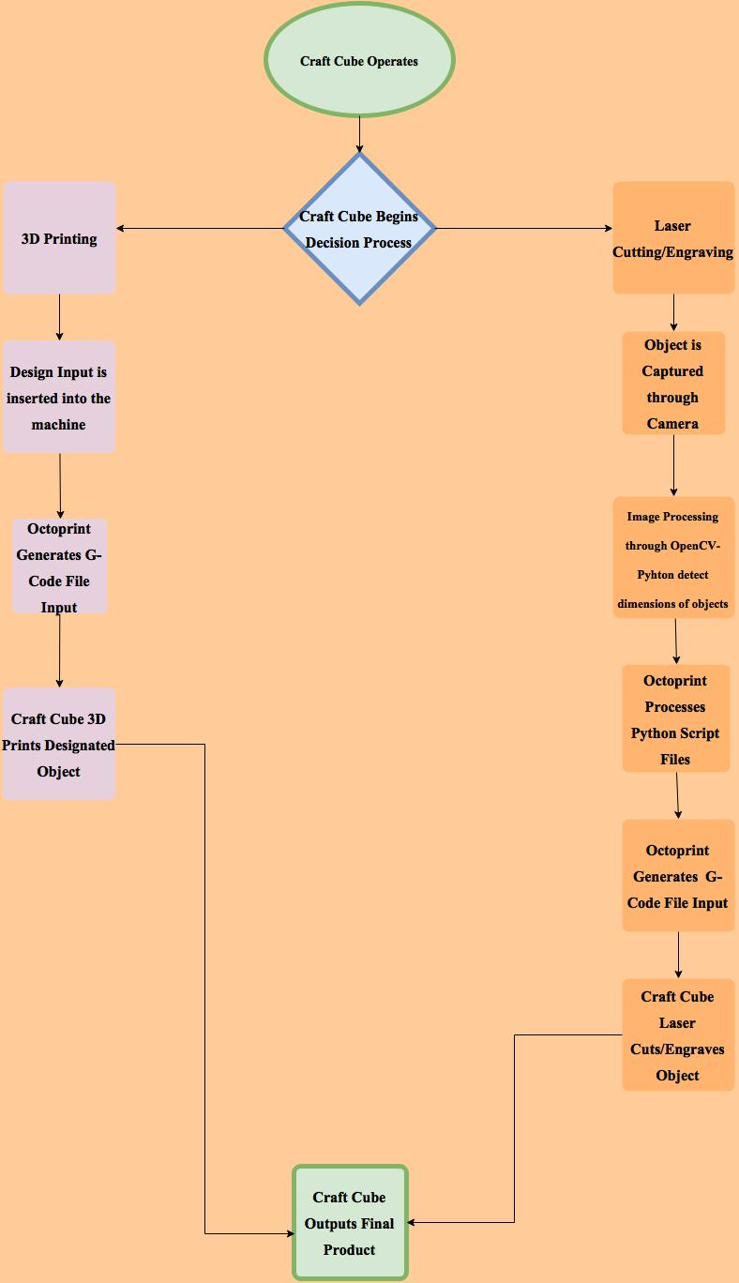
[picture p140: figure]
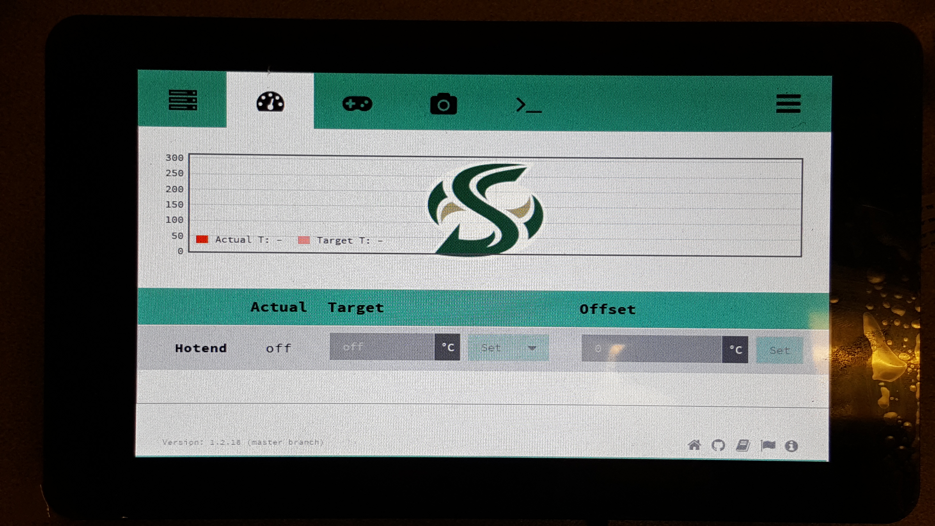
[picture p141: figure]

Craft Cube is a low cost 2 in 1 CNC machine utilizing a user-friendly operating system.

3D Model Management System

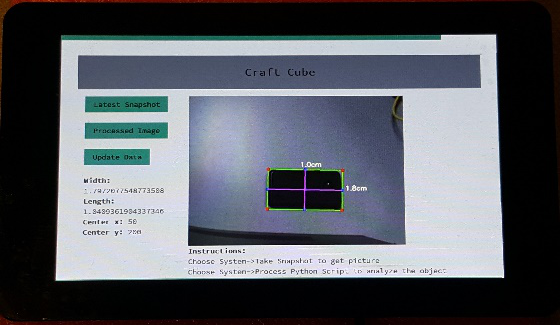
[picture p142: figure]
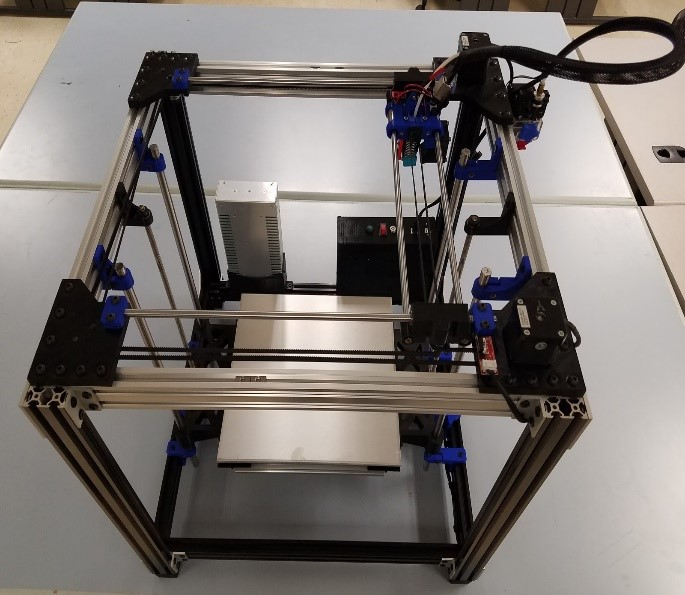
[picture p143: figure]

Flowchart

Detection Camera

CRAFT CUBE
