TBock3185/CraftCube/First Semester/Final presentation/IMG_0590.JPG

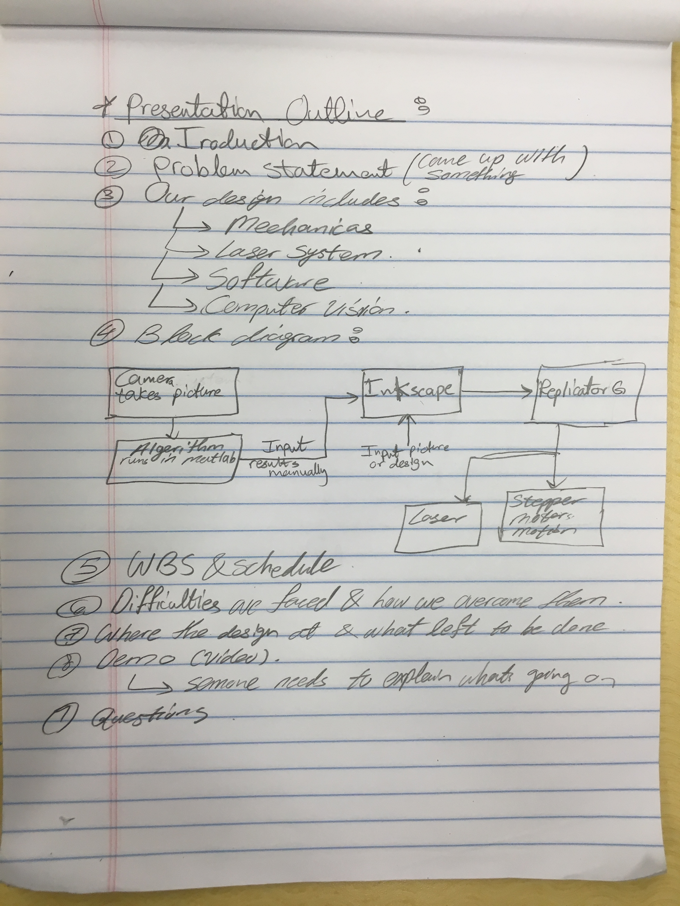
First Semester/Final presentation/IMG_0590.JPG
