TBock3185/CraftCube/First Semester/Week 1 - 2/Project Ideas/20160128_132032.jpg

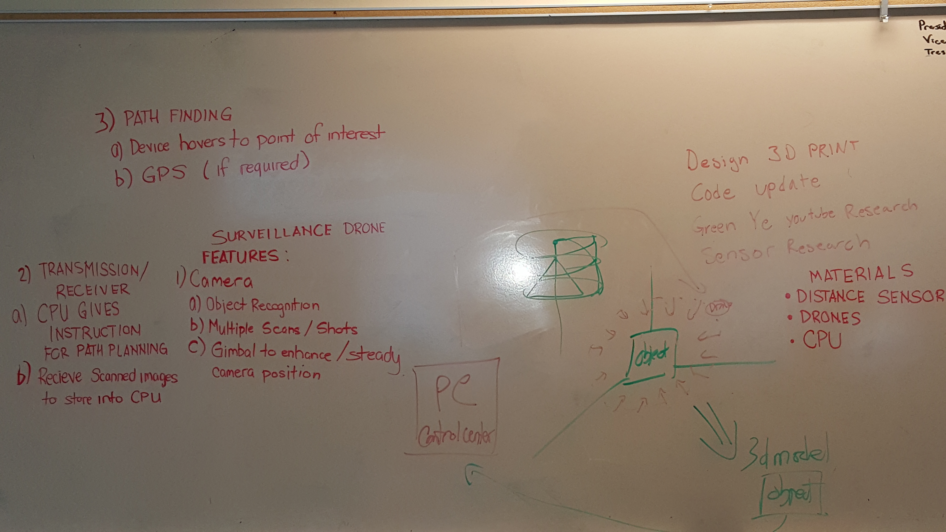
First Semester/Week 1 - 2/Project Ideas/20160128_132032.jpg
