TBock3185/CraftCube/First Semester/Week 1 - 2/Project Ideas/20160128_142541.jpg

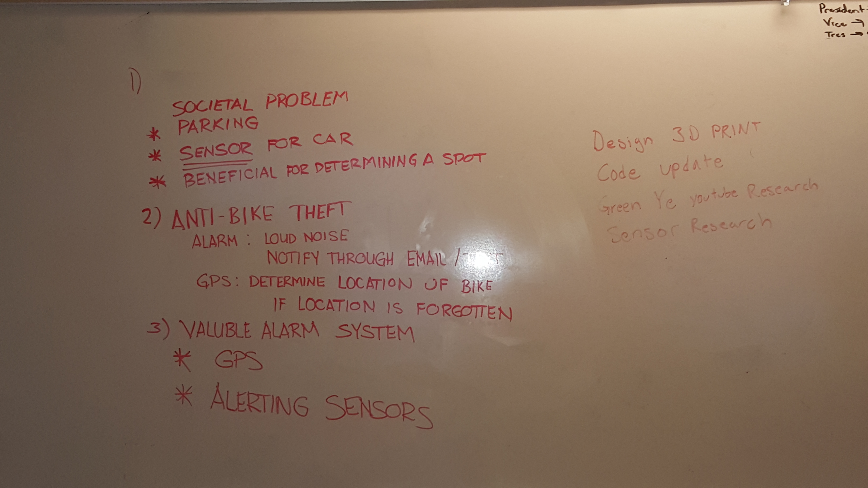
First Semester/Week 1 - 2/Project Ideas/20160128_142541.jpg
