TBock3185/CraftCube/First Semester/Week 3/20160210_164603.jpg

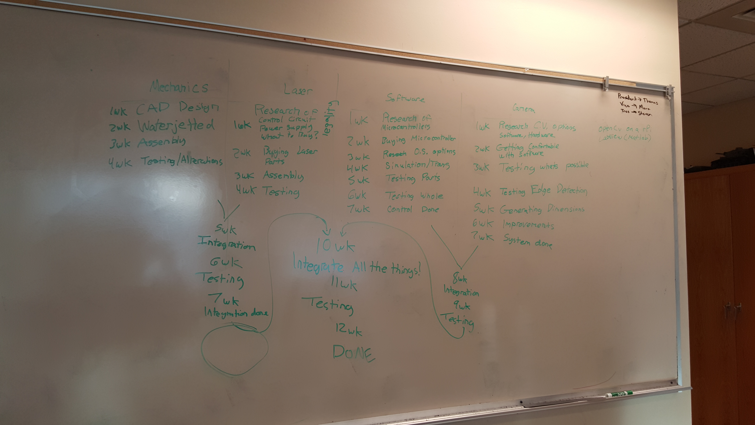
First Semester/Week 3/20160210_164603.jpg
