TBock3185/CraftCube/First Semester/Week 3/IMG_9929.JPG

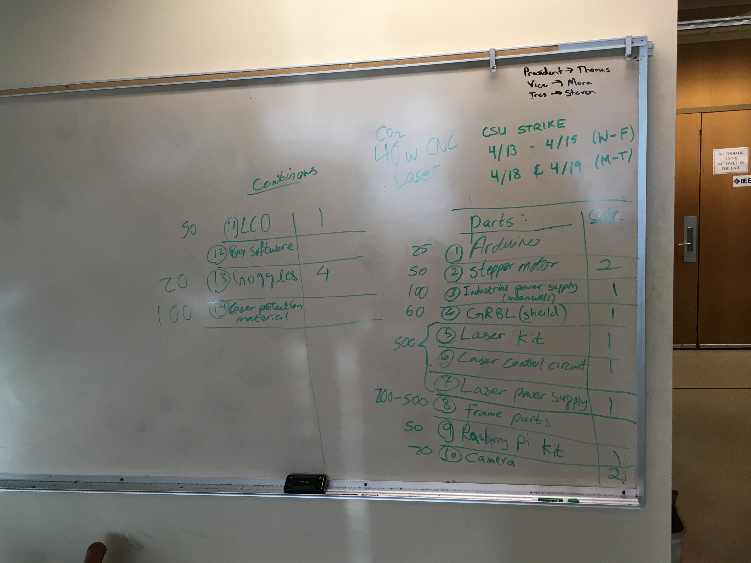
First Semester/Week 3/IMG_9929.JPG
