TBock3185/CraftCube/First Semester/Week 6/image000000.jpg

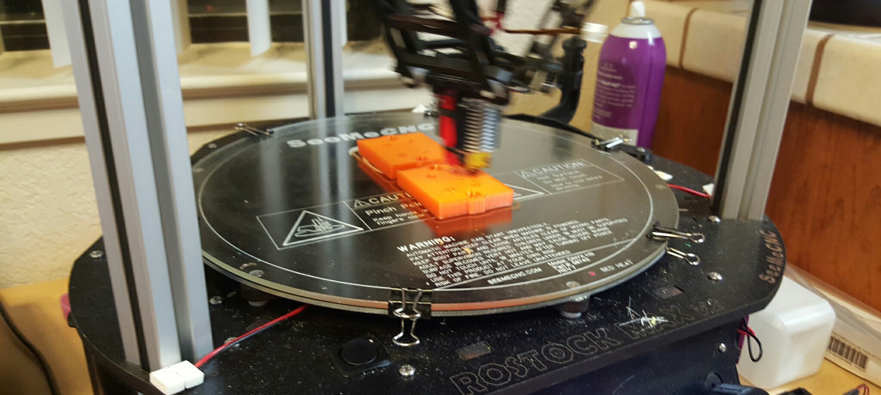
First Semester/Week 6/image000000.jpg
