TBock3185/CraftCube/First Semester/Week 10/20160328_175247.jpg

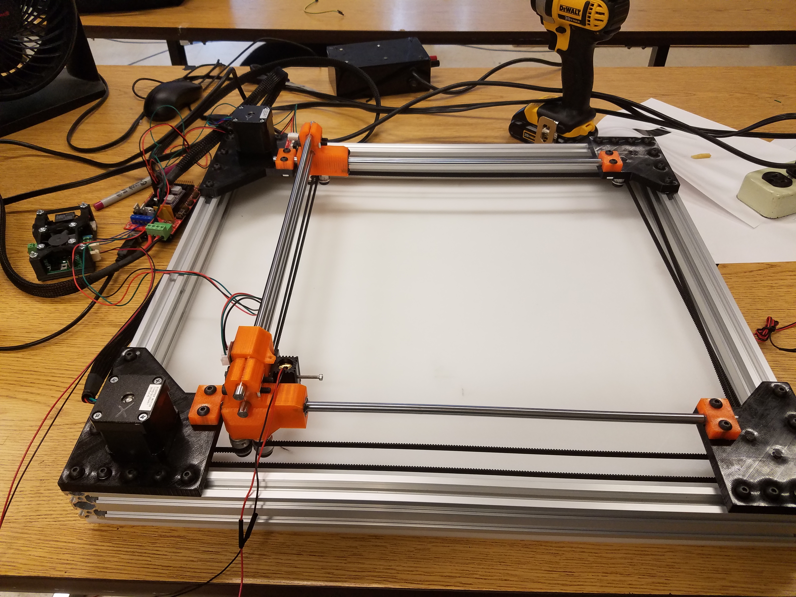
First Semester/Week 10/20160328_175247.jpg
