TBock3185/CraftCube/First Semester/Week 10/IMG_0255.JPG

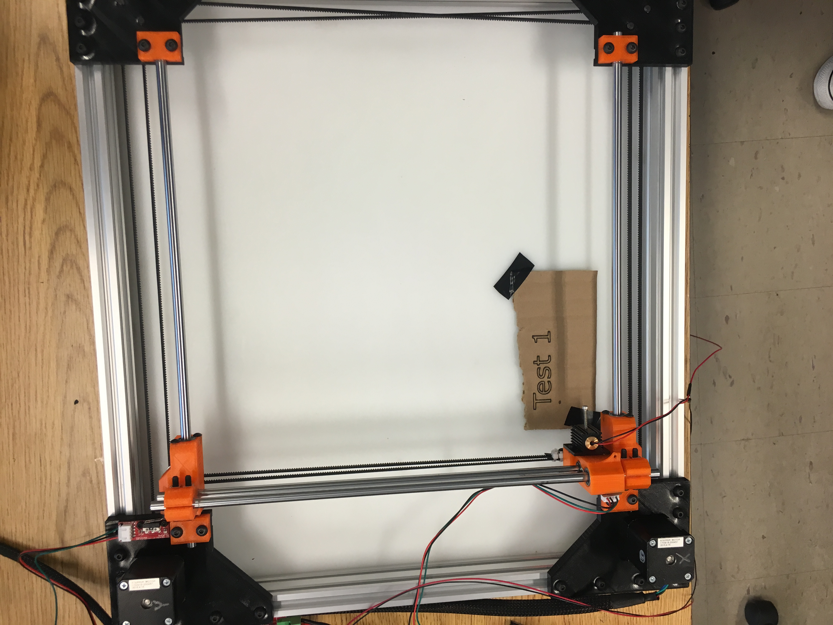
First Semester/Week 10/IMG_0255.JPG
