TBock3185/CraftCube/Second Semester/193B Final Poster Draft/20161010_150251.jpg

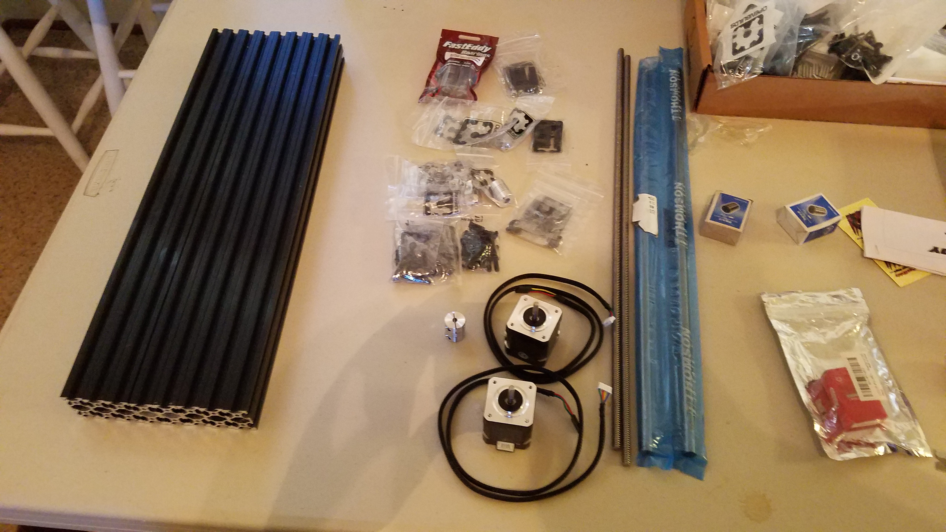
Second Semester/193B Final Poster Draft/20161010_150251.jpg
