TBock3185/CraftCube/First Semester/Week 3/Parts.xlsx

Parts | Quantity | Estimated Cost | Cost | Link to buy
Arduino | 1 | 25
Stepper motor | 2 | 50
Industrial power supply | 1 | 100
GRBL shield | 1 | 60
Laser Kit | 1 | 500
Laser Control Circuit' | 1
Laser Power Supply | 1
Frame Parts | 1 | 200-500
Raspberry Pi Kit | 1 | 50
Camera/Webcam | 2 | 20
Software | 1
Goggles | 4
Laser protection material | 1 | 100
