TBock3185/CraftCube/First Semester/Forms _ Syllabus/16 F SR  Design Group meetings Order.docx

Group meetings Order

Feb 17, Mar 2, Mar 16, Apr 6, April 20, and May 4

Teams: 9,8,5,6 and 7

Feb 24, Mar 9, Mar 30, Apr 13, Apr 27 and May 4

Teams: 4,3,1 and 2

Presentation Order Feb 24

1,2,3,9,7,5,6,8 and 4
