TBock3185/CraftCube/Second Semester/Forms _ Syllabus/16 Sp 190 193 Peer Evaluations.xls

 | CpE 190 / EEE 193A
Please submit one copy for each member including yourself.
Due Feb 22, Mar 14 and May 16
Name: Date:
Group:
SKILLS AND BEHAVIORS | Not satisfactory | OK | Good | Not applicable
Planning
Decision Making
Communication
Organizational/Time Management
Punctuality meetings and assignments
Flexibility
Responsiveness
Problem Solving
Teamwork
Professionalism
Initiative
Technical Knowledge
Contribution -Hardware
Contribution - Software
Contribution-Documentation
Contribution-Mechanical
Other skills appropriate
Please Comment on quality of support you receive from this person
What are his/her greatest strengths
What areas needs attention
Name of evaluator:
