TBock3185/CraftCube/First Semester/Week 13/Gant Chart(4_20_16).pdf

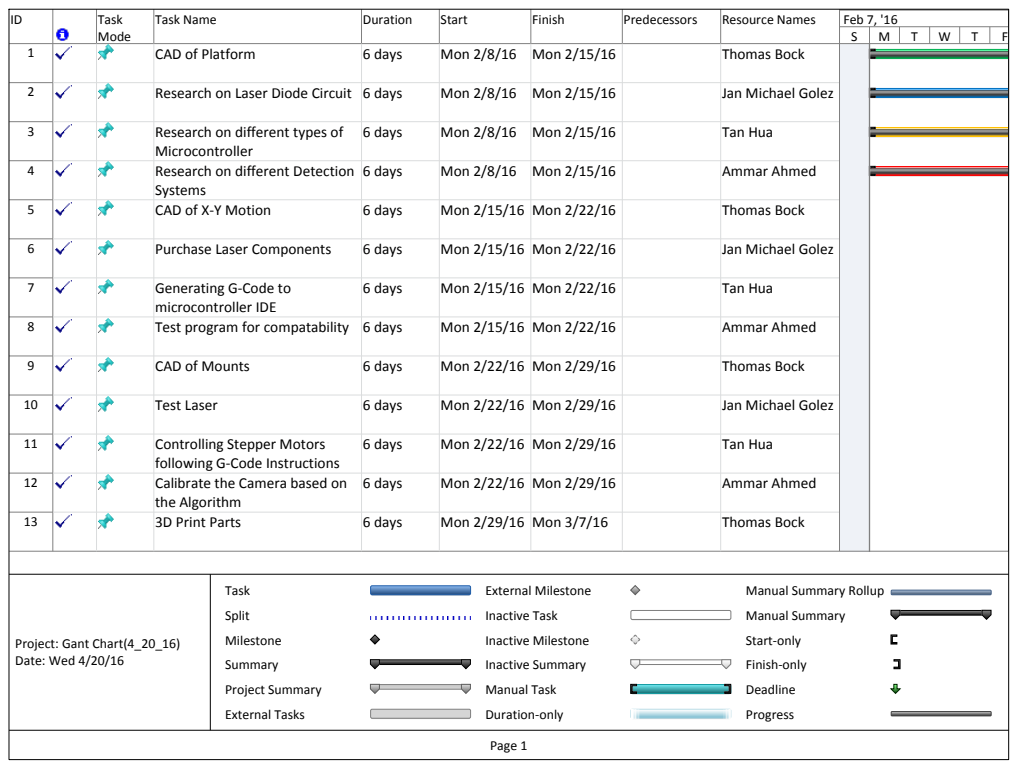
[picture p158: page 1]
Task; Mode; Task Name; Duration; Start; Finish; Predecessors; Resource Names; CAD of Platform; 6 days; Mon 2/8/16; Mon 2/15/16; Thomas Bock; Research on Laser Diode Circuit; Jan Michael Golez; Research on different types of; Microcontroller; Tan Hua; Research on different Detection; Systems; Ammar Ahmed; CAD of X-Y Motion; Mon 2/22/16; Purchase Laser Components; Generating G-Code to; microcontroller IDE; Test program for compatability; CAD of Mounts; Mon 2/29/16; Test Laser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

following G-Code Instructions

Manual Summary Rollup
Manual Summary
Start-only
Finish-only
Deadline
Progress

Project: Gant Chart(4_20_16)
Date: Wed 4/20/16

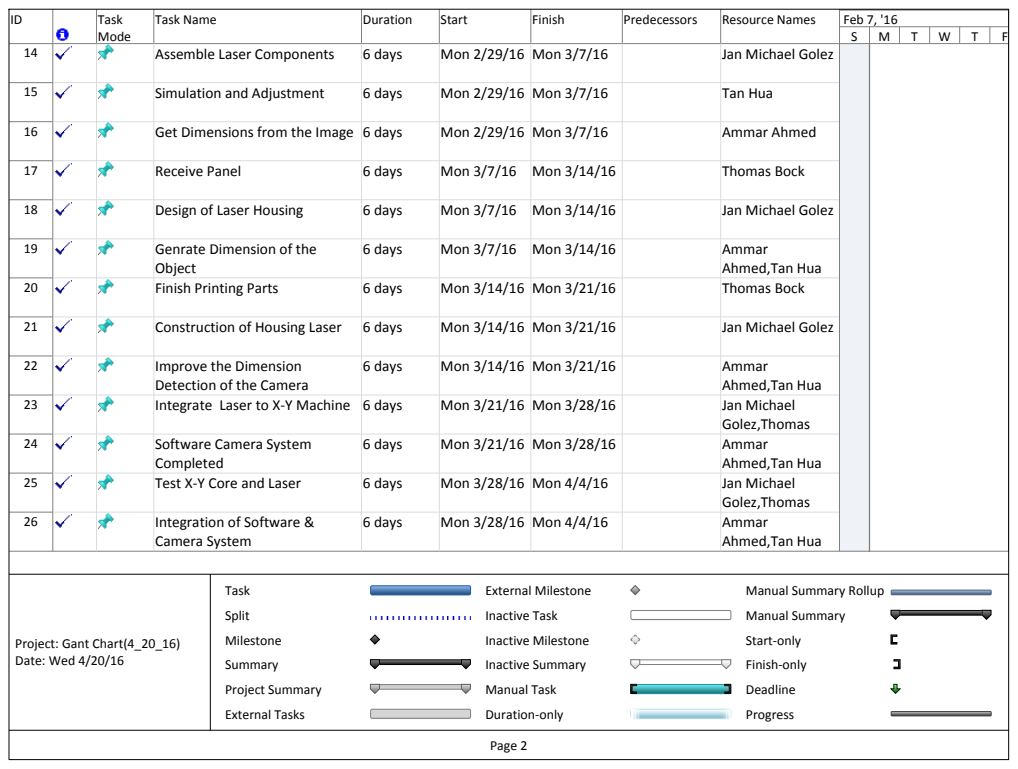
[picture p159: page 2]
Task; Mode; Task Name; Duration; Start; Finish; Predecessors; Resource Names; Assemble Laser Components; 6 days; Mon 2/29/16; Mon 3/7/16; Jan Michael Golez; Simulation and Adjustment; Tan Hua; Get Dimensions from the Image; Ammar Ahmed; Receive Panel; Mon 3/14/16; Thomas Bock; Design of Laser Housing; Genrate Dimension of the; Object; Ammar; Finish Printing Parts; Mon 3/21/16; Construction of Housing Laser; Improve the Dimension; Integrate Laser to X-Y Machine; Mon 3/28/16; Jan Michael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

Ahmed,Tan Hua

Detection of the Camera

Manual Summary Rollup
Manual Summary
Start-only
Finish-only
Deadline
Progress

Project: Gant Chart(4_20_16)
Date: Wed 4/20/16

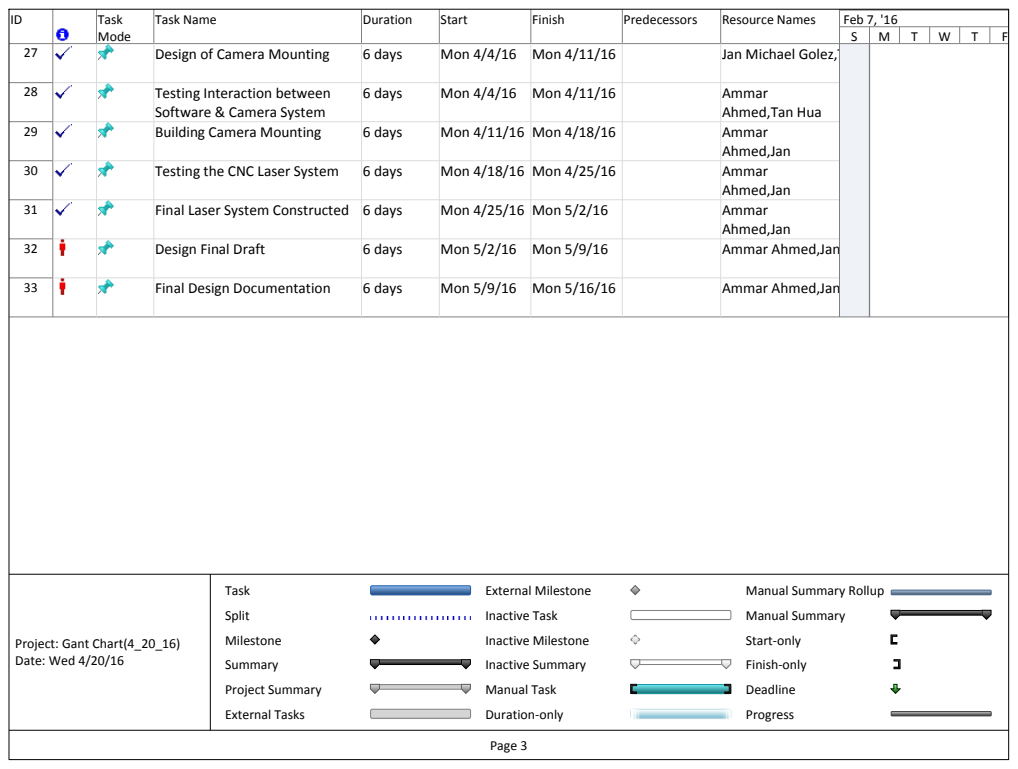
[picture p160: page 3]
Task; Mode; Task Name; Duration; Start; Finish; Predecessors; Resource Names; Design of Camera Mounting; 6 days; Mon 4/4/16; Mon 4/11/16; Jan Michael Golez,Thomas Bock; Testing Interaction between; Ammar; Building Camera Mounting; Mon 4/18/16; Ahmed,Jan; Testing the CNC Laser System; Mon 4/25/16; Final Laser System Constructed; Mon 5/2/16; Design Final Draft; Mon 5/9/16; Ammar Ahmed,Jan Michael Golez,Tan Hua,Thomas Bock; Final Design Documentation; Mon 5/16/16; Feb 7, '16; Split; Milestone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

Software & Camera System

Ahmed,Tan Hua

Manual Summary Rollup
Manual Summary
Start-only
Finish-only
Deadline
Progress

Project: Gant Chart(4_20_16)
Date: Wed 4/20/16

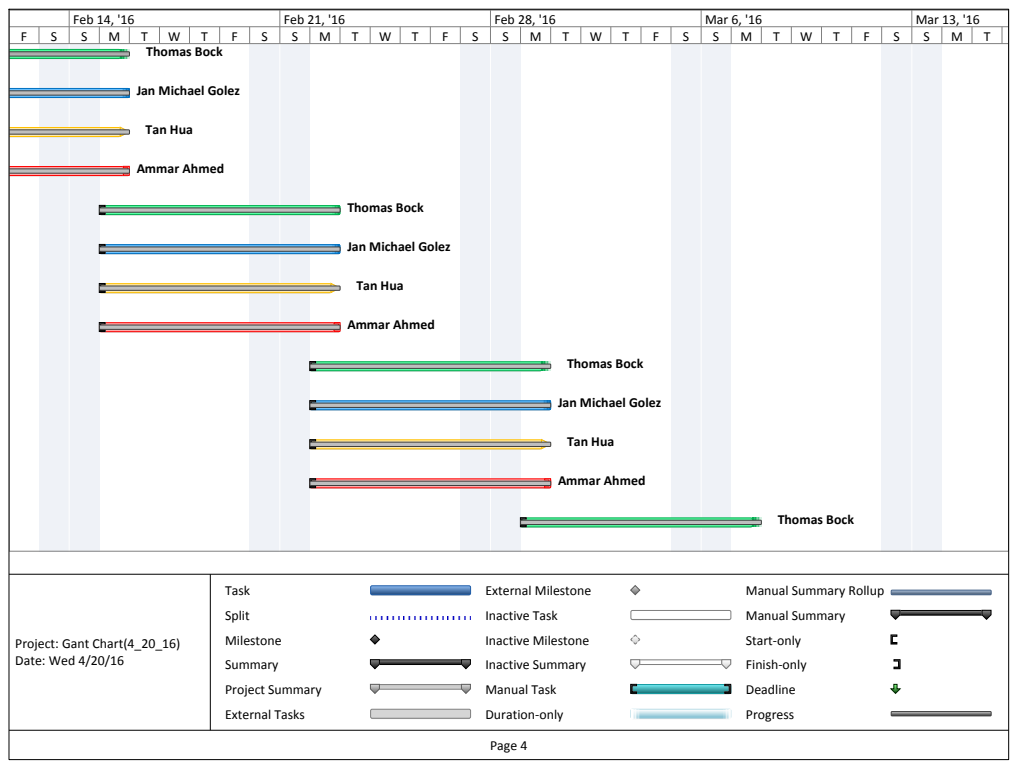
[picture p161: page 4]
Thomas Bock; Tan Hua; Ammar Ahmed; Task; Split; Milestone; Summary; Project Summary; External Tasks; External Milestone; Inactive Task; Inactive Milestone; Inactive Summary; Manual Task; Duration-only

Feb 14, '16 | Feb 21, '16 | Feb 28, '16 | Mar 6, '16 | Mar 13, '16

Jan Michael Golez

Manual Summary Rollup
Manual Summary
Start-only
Finish-only
Deadline
Progress

Project: Gant Chart(4_20_16)
Date: Wed 4/20/16

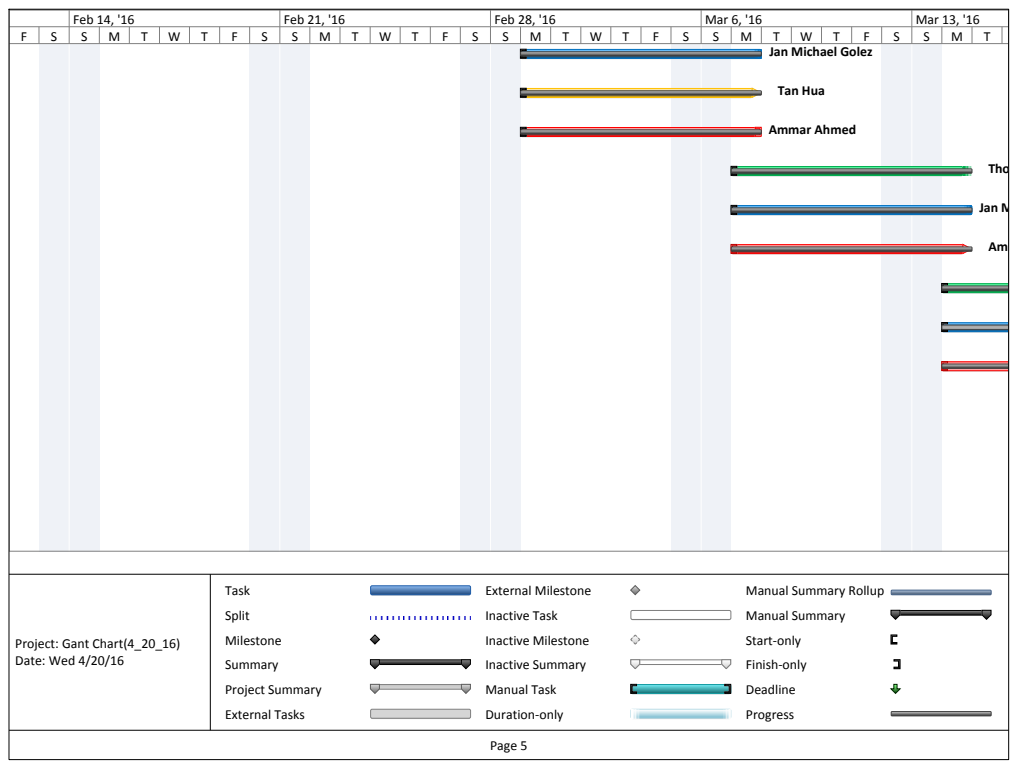
[picture p162: page 5]
Tan Hua; Ammar Ahmed; Thomas Bock; Task; Split; Milestone; Summary; Project Summary; External Tasks; External Milestone; Inactive Task; Inactive Milestone; Inactive Summary; Manual Task; Duration-only

Feb 14, '16 | Feb 21, '16 | Feb 28, '16 | Mar 6, '16 | Mar 13, '16

Jan Michael Golez

Ammar Ahmed,Tan Hua

Manual Summary Rollup
Manual Summary
Start-only
Finish-only
Deadline
Progress

Project: Gant Chart(4_20_16)
Date: Wed 4/20/16

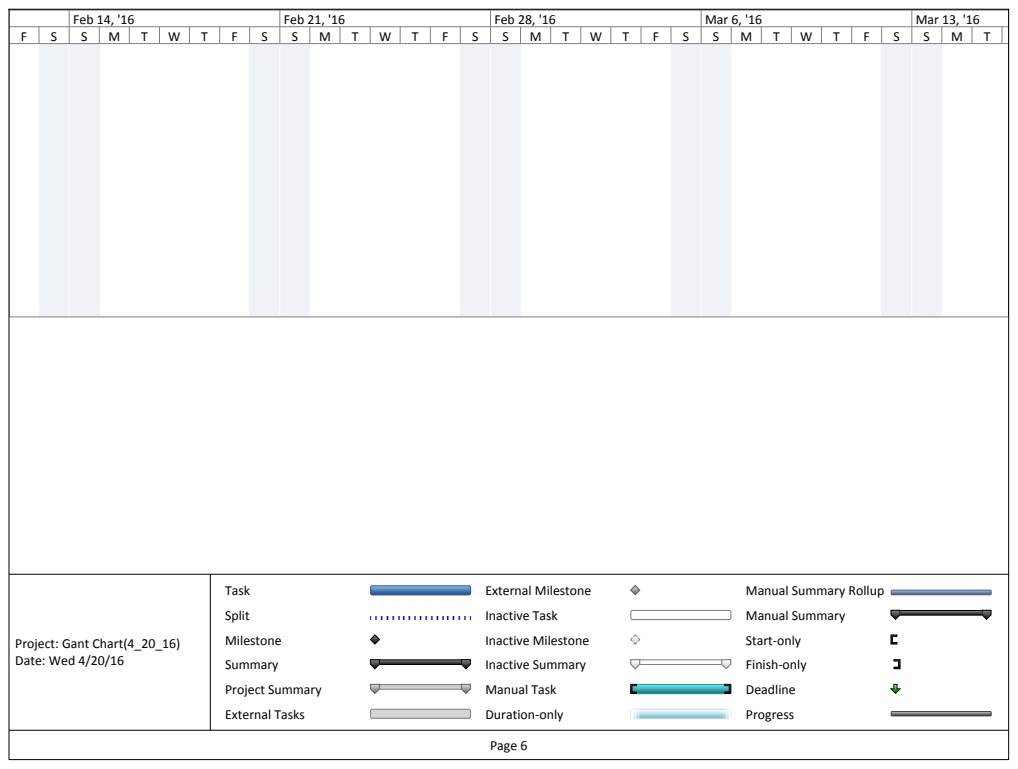
[picture p163: page 6]
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

Feb 14, '16 | Feb 21, '16 | Feb 28, '16 | Mar 6, '16 | Mar 13, '16

Manual Summary Rollup
Manual Summary
Start-only
Finish-only
Deadline
Progress

Project: Gant Chart(4_20_16)
Date: Wed 4/20/16

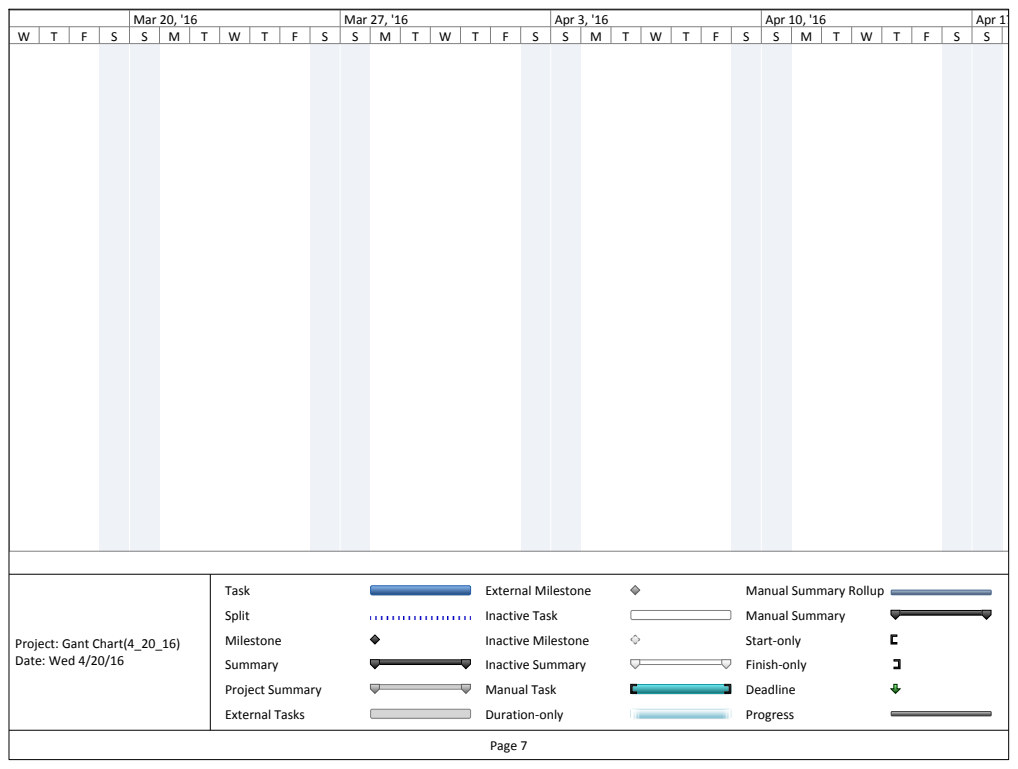
[picture p164: page 7]
Mar 20, '16; Mar 27, '16; Apr 3, '16; Apr 10, '16; Apr 17, '16; Task; Split; Milestone; Summary; Project Summary; External Tasks; External Milestone; Inactive Task; Inactive Milestone; Inactive Summary; Manual Task; Duration-only

Manual Summary Rollup
Manual Summary
Start-only
Finish-only
Deadline
Progress

Project: Gant Chart(4_20_16)
Date: Wed 4/20/16

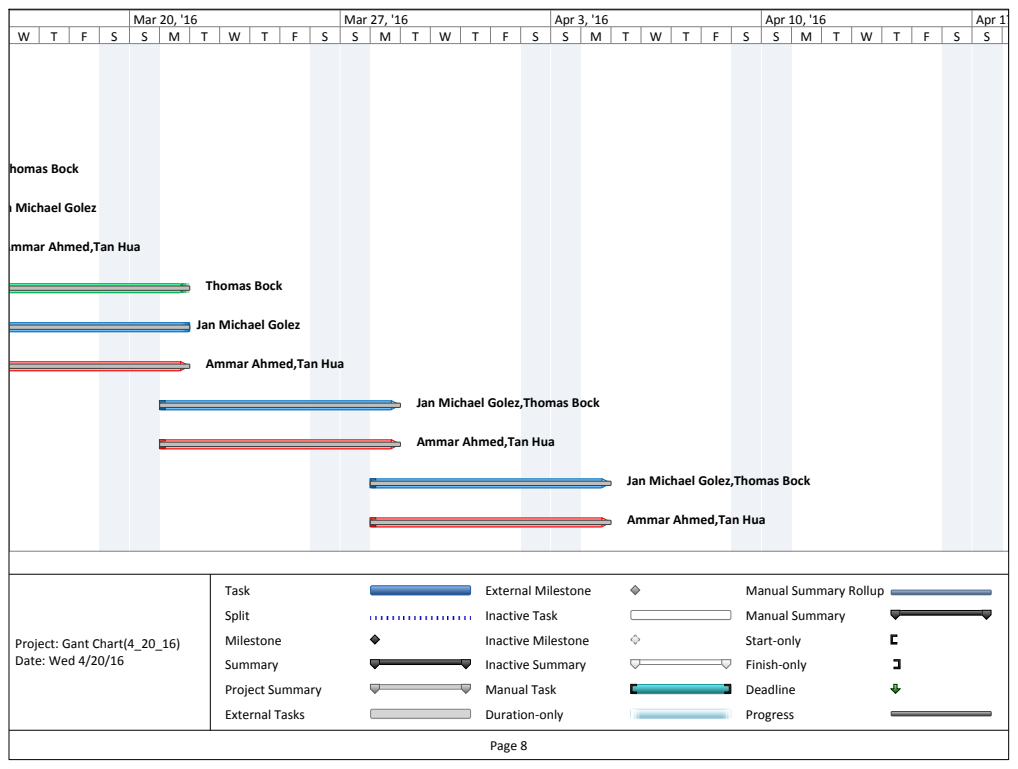
[picture p165: page 8]
Thomas Bock; Mar 20, '16; Mar 27, '16; Apr 3, '16; Apr 10, '16; Apr 17, '16; Task; Split; Milestone; Summary; Project Summary; External Tasks; External Milestone; Inactive Task; Inactive Milestone; Inactive Summary; Manual Task; Duration-only

Jan Michael Golez

Ammar Ahmed,Tan Hua

Jan Michael Golez,Thomas Bock

Manual Summary Rollup
Manual Summary
Start-only
Finish-only
Deadline
Progress

Project: Gant Chart(4_20_16)
Date: Wed 4/20/16

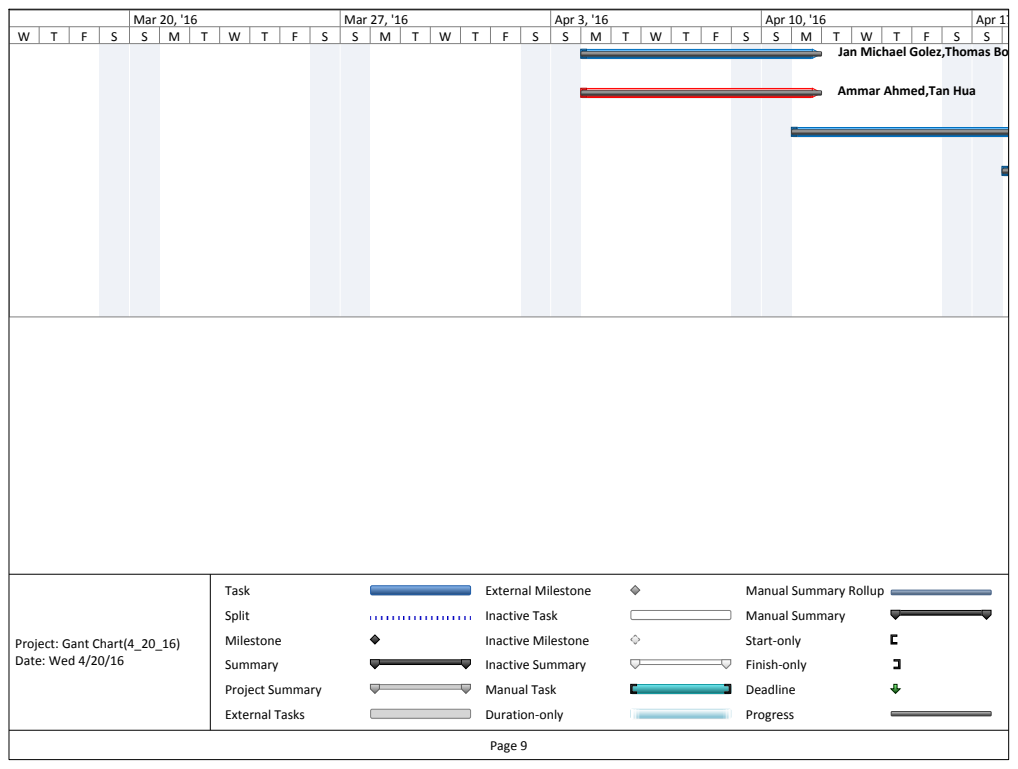
[picture p166: page 9]
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

Jan Michael Golez,Thomas Bock

Ammar Ahmed,Tan Hua

Manual Summary Rollup
Manual Summary
Start-only
Finish-only
Deadline
Progress

Project: Gant Chart(4_20_16)
Date: Wed 4/20/16

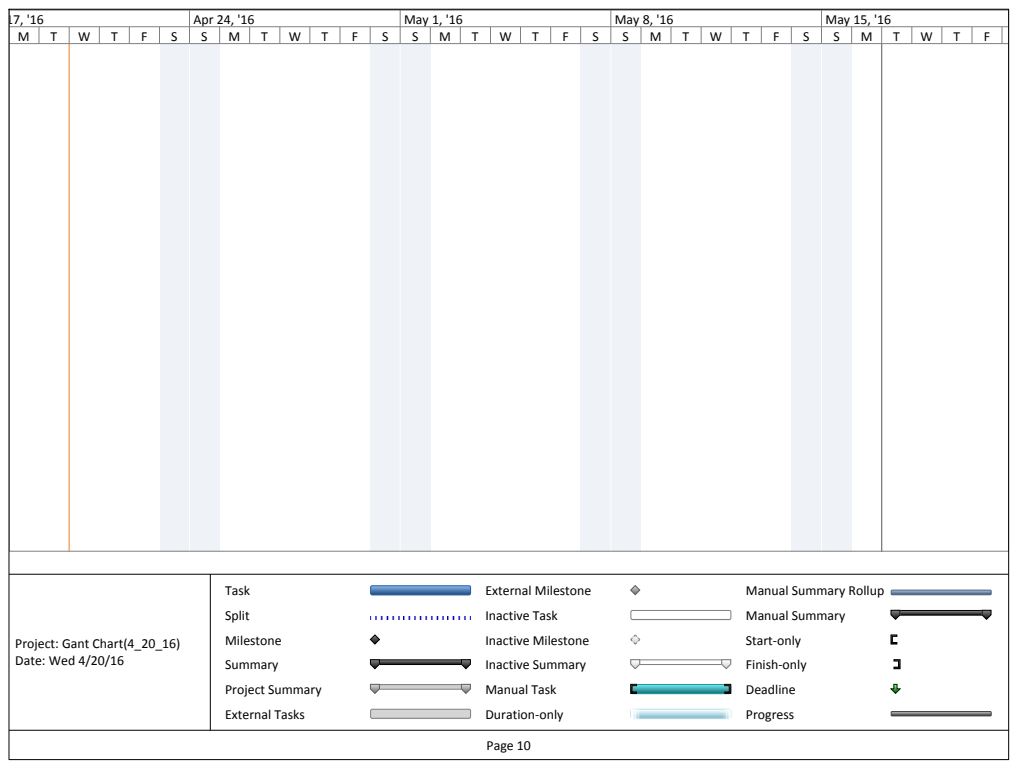
[picture p167: page 10]
Apr 17, '16; Apr 24, '16; May 1, '16; May 8, '16; May 15, '16; Task; Split; Milestone; Summary; Project Summary; External Tasks; External Milestone; Inactive Task; Inactive Milestone; Inactive Summary; Manual Task; Duration-only

Manual Summary Rollup
Manual Summary
Start-only
Finish-only
Deadline
Progress

Project: Gant Chart(4_20_16)
Date: Wed 4/20/16

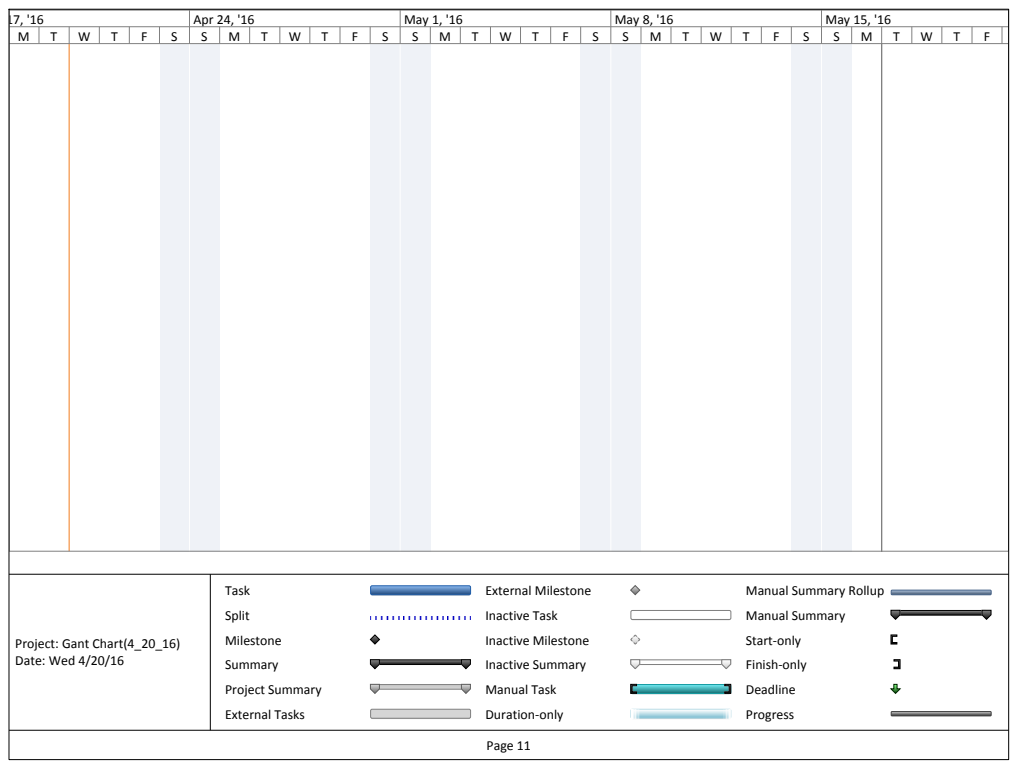
[picture p168: page 11]
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

Manual Summary Rollup
Manual Summary
Start-only
Finish-only
Deadline
Progress

Project: Gant Chart(4_20_16)
Date: Wed 4/20/16

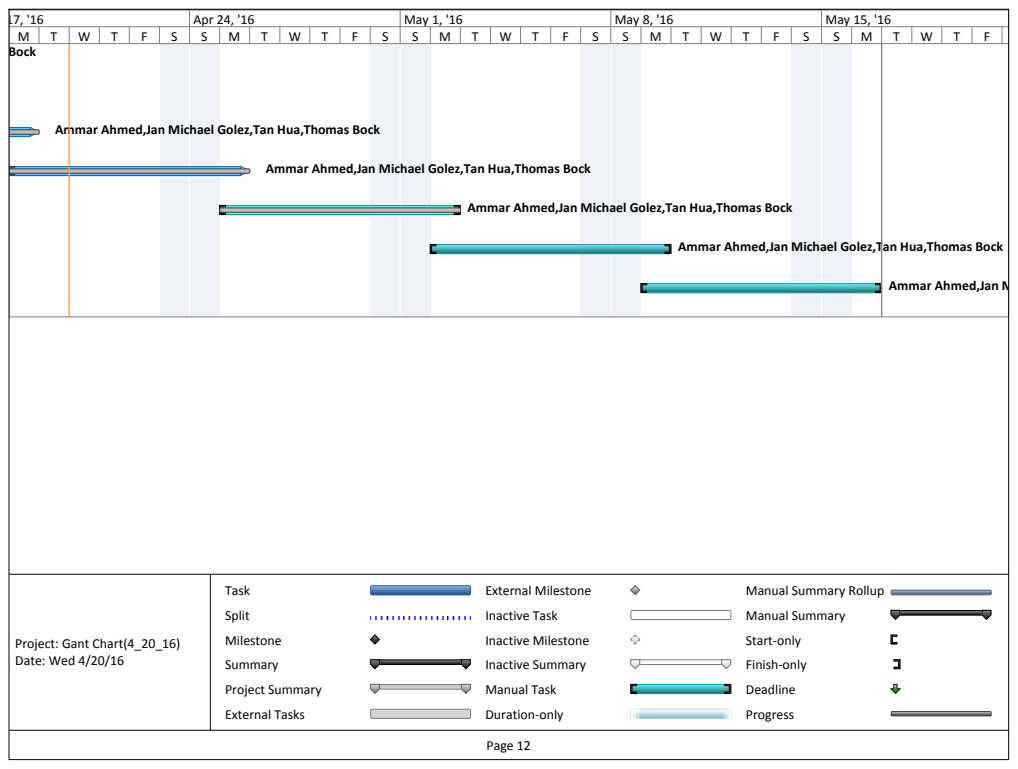
[picture p169: page 12]
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

Jan Michael Golez,Thomas Bock

Ammar Ahmed,Tan Hua

Ammar Ahmed,Jan Michael Golez,Tan Hua,Thomas Bock

Manual Summary Rollup
Manual Summary
Start-only
Finish-only
Deadline
Progress

Project: Gant Chart(4_20_16)
Date: Wed 4/20/16
