TBock3185/CraftCube/First Semester/Week 5/Gant Chart.pdf

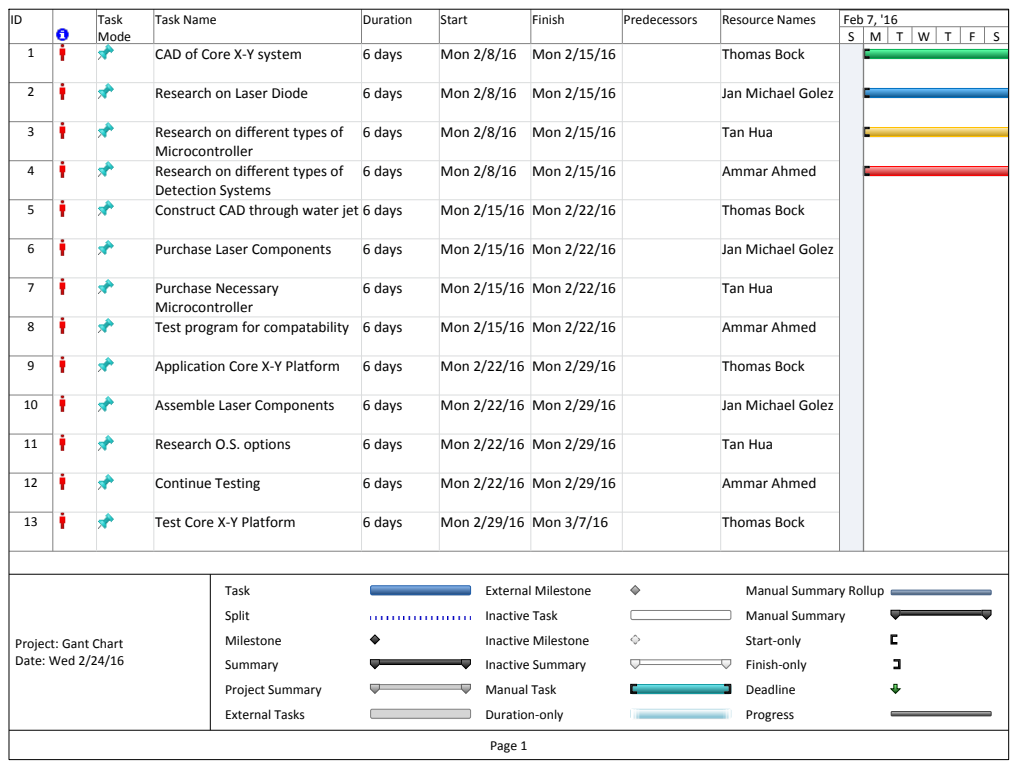
[picture p179: page 1]
Task; Mode; Task Name; Duration; Start; Finish; Predecessors; Resource Names; CAD of Core X-Y system; 6 days; Mon 2/8/16; Mon 2/15/16; Thomas Bock; Research on Laser Diode; Jan Michael Golez; Research on different types of; Microcontroller; Tan Hua; Detection Systems; Ammar Ahmed; Construct CAD through water jet 6 days; Mon 2/22/16; Purchase Laser Components; Purchase Necessary; Test program for compatability; Application Core X-Y Platform; Mon 2/29/16; Assemble Laser Components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

Manual Summary Rollup
Manual Summary
Start-only
Finish-only
Deadline
Progress

Project: Gant Chart
Date: Wed 2/24/16

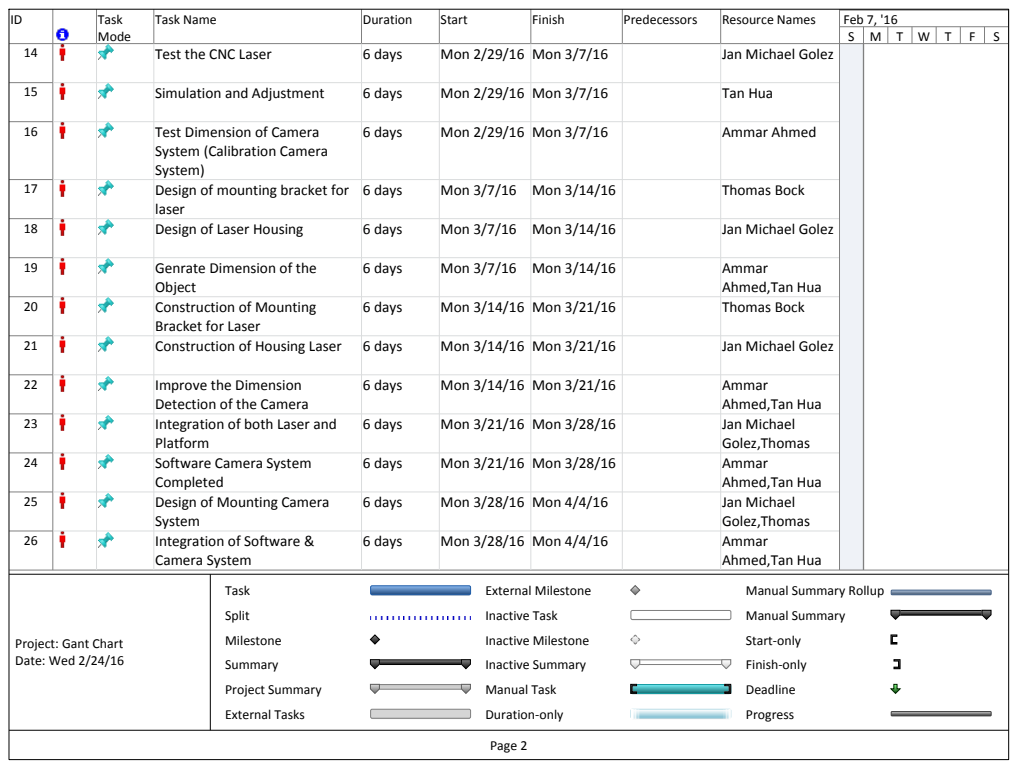
[picture p180: page 2]
Task; Mode; Task Name; Duration; Start; Finish; Predecessors; Resource Names; Test the CNC Laser; 6 days; Mon 2/29/16; Mon 3/7/16; Jan Michael Golez; Simulation and Adjustment; Tan Hua; Test Dimension of Camera; Ammar Ahmed; Design of mounting bracket for; laser; Mon 3/14/16; Thomas Bock; Design of Laser Housing; Genrate Dimension of the; Object; Ammar; Construction of Mounting; Mon 3/21/16; Construction of Housing Laser; Improve the Dimension; Integration of both Laser and; Platform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

System (Calibration Camera
System)

Ahmed,Tan Hua

Bracket for Laser

Detection of the Camera

Manual Summary Rollup
Manual Summary
Start-only
Finish-only
Deadline
Progress

Project: Gant Chart
Date: Wed 2/24/16

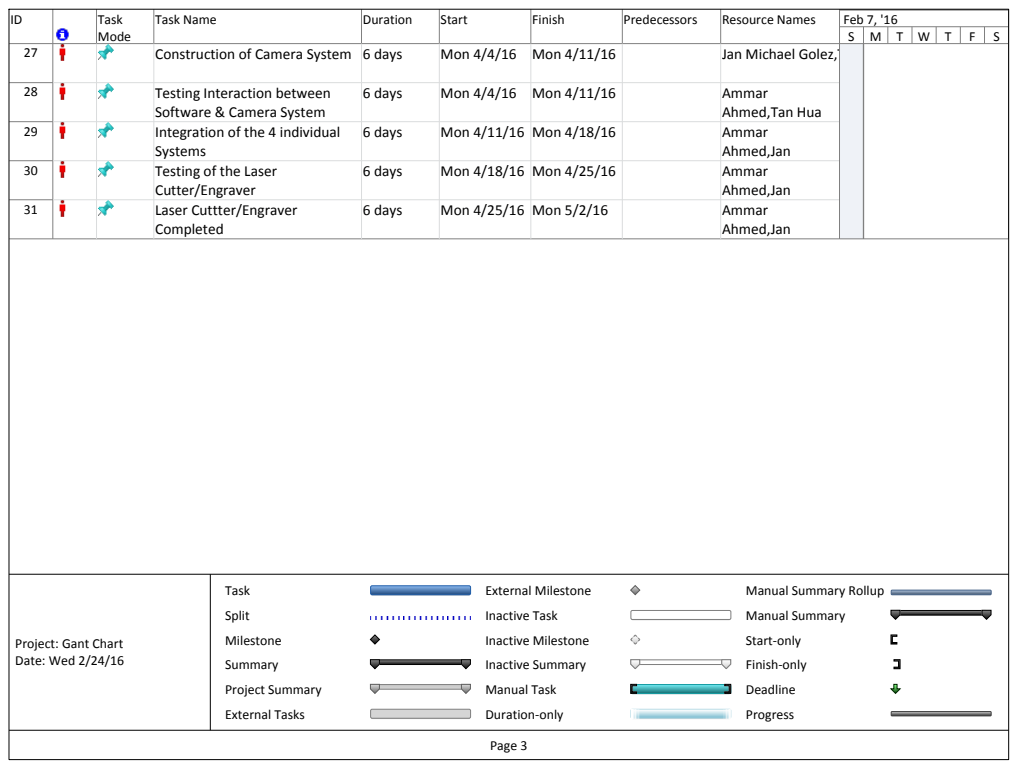
[picture p181: page 3]
Task; Mode; Task Name; Duration; Start; Finish; Predecessors; Resource Names; Construction of Camera System; 6 days; Mon 4/4/16; Mon 4/11/16; Jan Michael Golez,Thomas Bock; Testing Interaction between; Ammar; Integration of the 4 individual; Systems; Mon 4/18/16; Ahmed,Jan; Testing of the Laser; Cutter/Engraver; Mon 4/25/16; Laser Cuttter/Engraver; Completed; Mon 5/2/16; Feb 7, '16; Split; Milestone; Summary; Project Summary; External Tasks; External Milestone; Inactive Task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

Software & Camera System

Ahmed,Tan Hua

Manual Summary Rollup
Manual Summary
Start-only
Finish-only
Deadline
Progress

Project: Gant Chart
Date: Wed 2/24/16

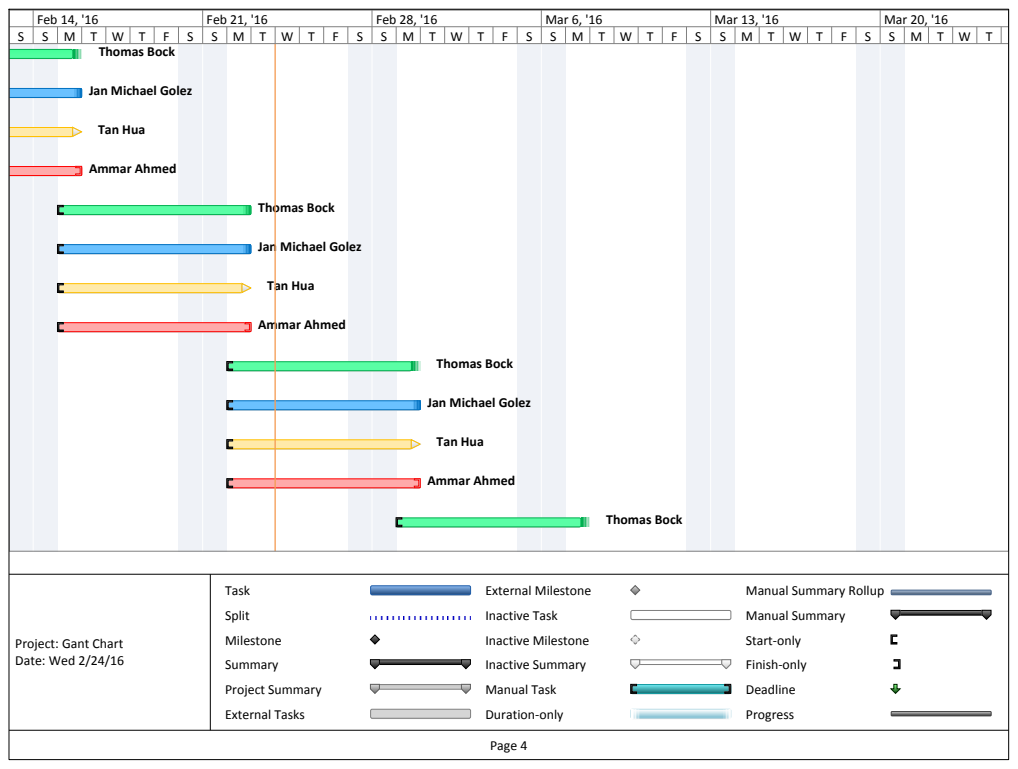
[picture p182: page 4]
Thomas Bock; Tan Hua; Ammar Ahmed; Task; Split; Milestone; Summary; Project Summary; External Tasks; External Milestone; Inactive Task; Inactive Milestone; Inactive Summary; Manual Task; Duration-only

Feb 14, '16 | Feb 21, '16 | Feb 28, '16 | Mar 6, '16 | Mar 13, '16 | Mar 20, '16

Jan Michael Golez

Manual Summary Rollup
Manual Summary
Start-only
Finish-only
Deadline
Progress

Project: Gant Chart
Date: Wed 2/24/16

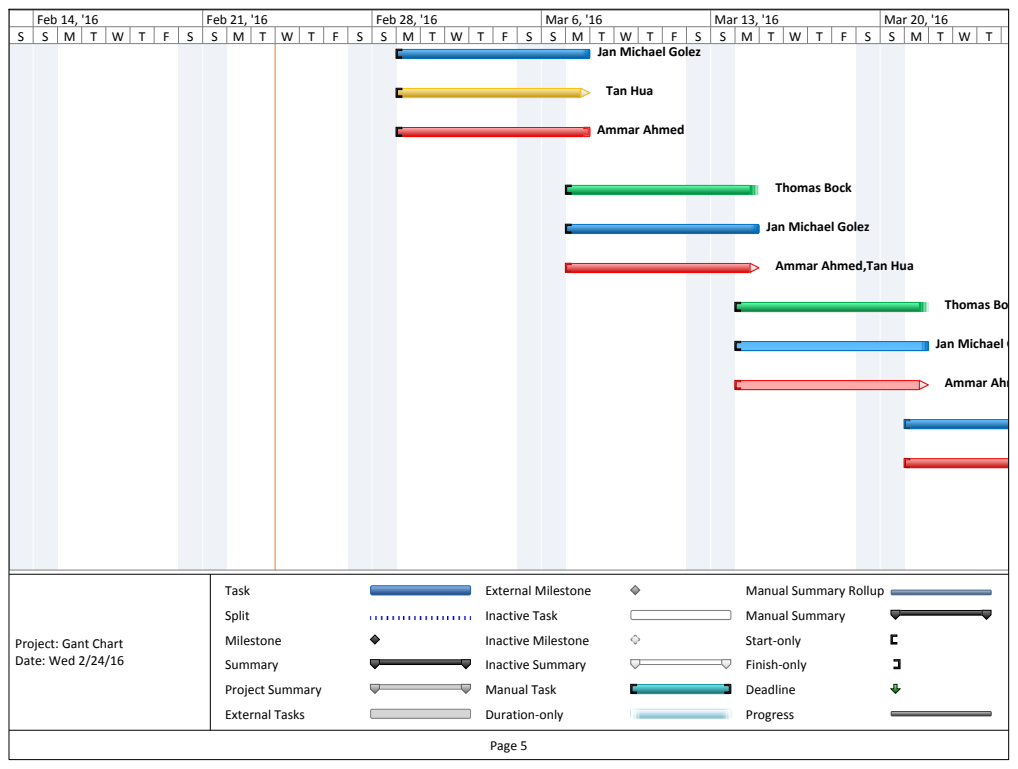
[picture p183: page 5]
Tan Hua; Ammar Ahmed; Thomas Bock; Task; Split; Milestone; Summary; Project Summary; External Tasks; External Milestone; Inactive Task; Inactive Milestone; Inactive Summary; Manual Task; Duration-only

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

Jan Michael Golez

Ammar Ahmed,Tan Hua

Manual Summary Rollup
Manual Summary
Start-only
Finish-only
Deadline
Progress

Project: Gant Chart
Date: Wed 2/24/16

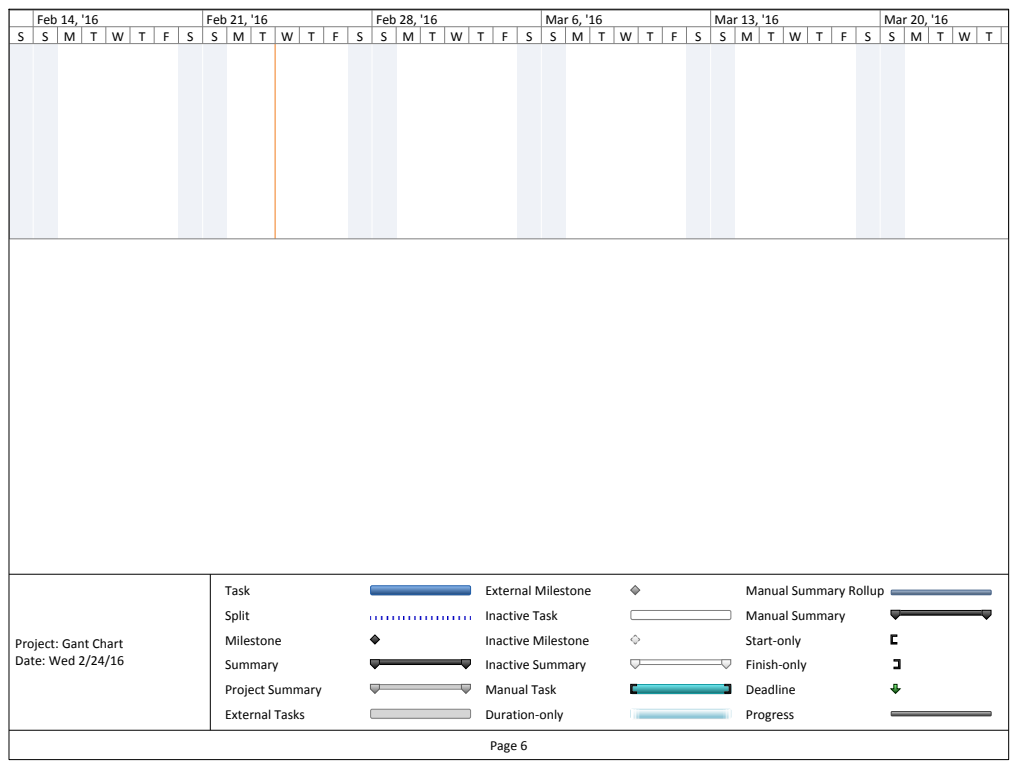
[picture p184: page 6]
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

Manual Summary Rollup
Manual Summary
Start-only
Finish-only
Deadline
Progress

Project: Gant Chart
Date: Wed 2/24/16

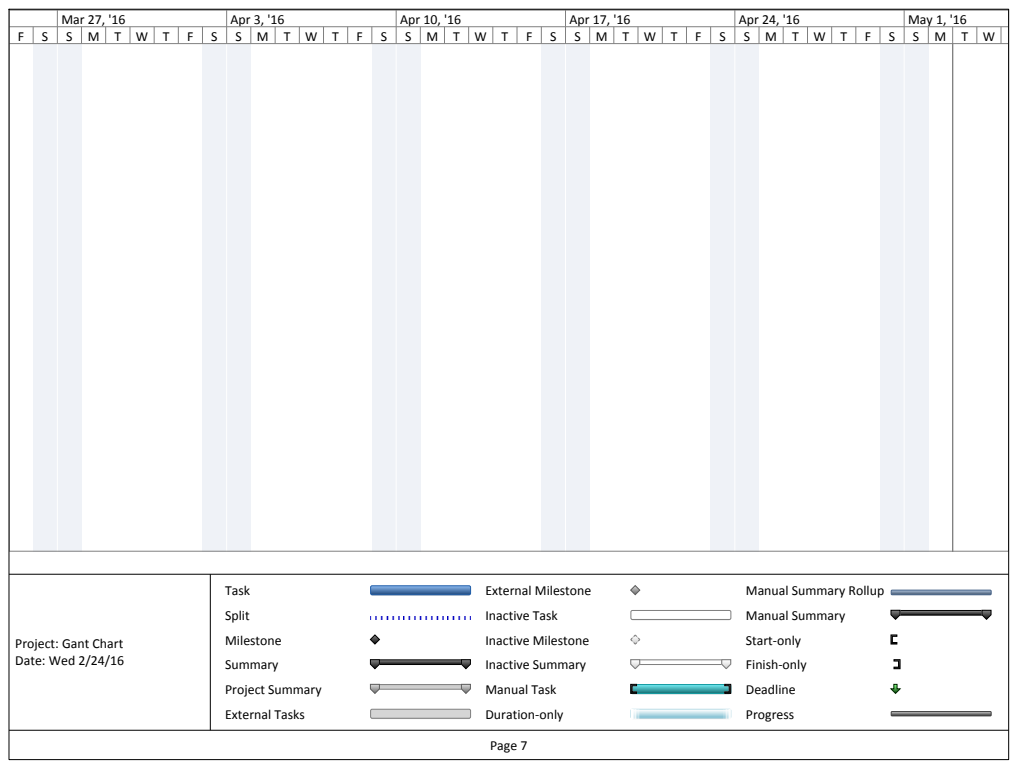
[picture p185: page 7]
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

Mar 27, '16 | Apr 3, '16 | Apr 10, '16 | Apr 17, '16 | Apr 24, '16 | May 1, '16

Manual Summary Rollup
Manual Summary
Start-only
Finish-only
Deadline
Progress

Project: Gant Chart
Date: Wed 2/24/16

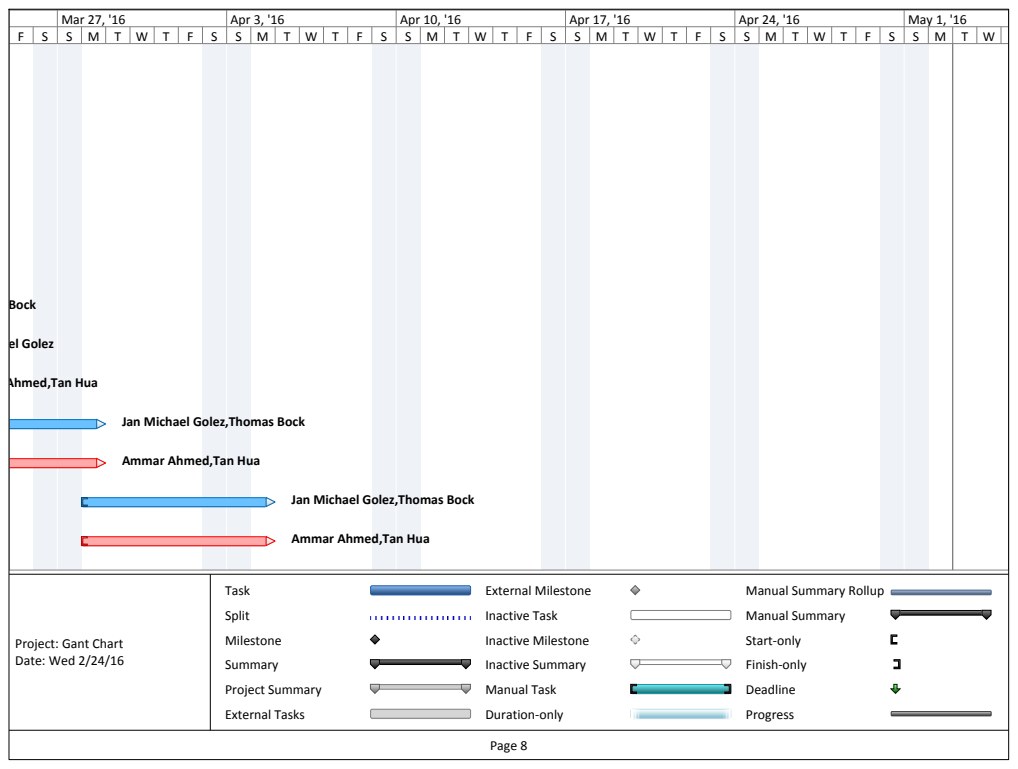
[picture p186: page 8]
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

Jan Michael Golez

Ammar Ahmed,Tan Hua

Jan Michael Golez,Thomas Bock

Manual Summary Rollup
Manual Summary
Start-only
Finish-only
Deadline
Progress

Project: Gant Chart
Date: Wed 2/24/16

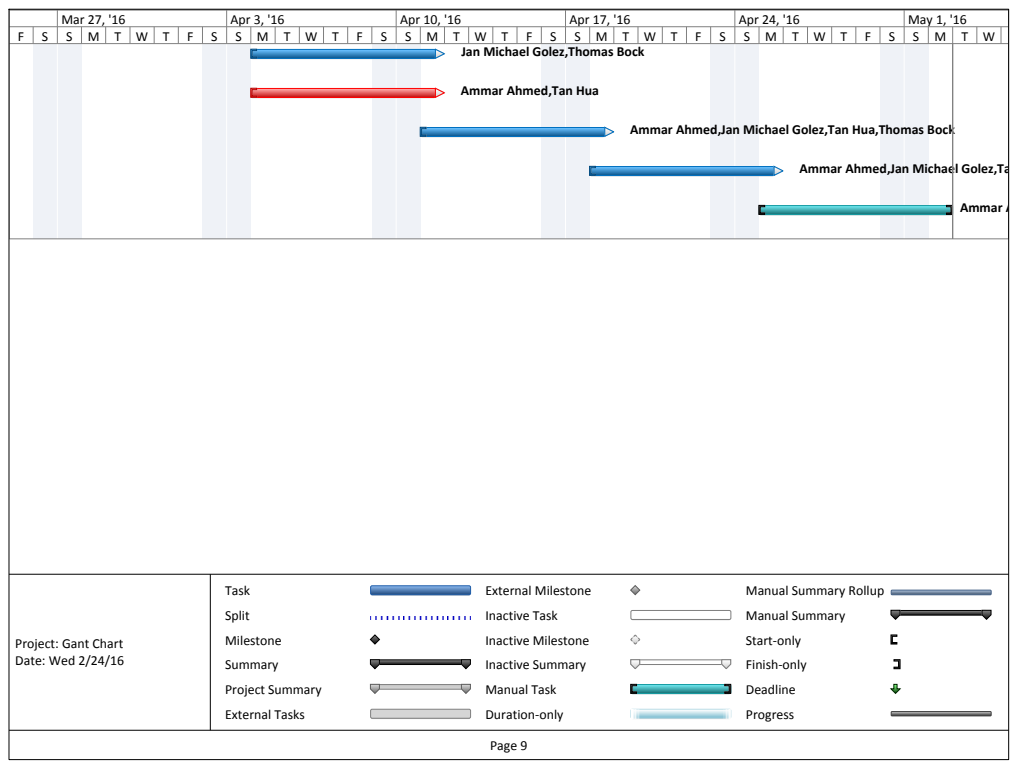
[picture p187: page 9]
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

Jan Michael Golez,Thomas Bock Ammar Ahmed,Tan Hua | | | | | | | Ammar Ahmed,Jan Michael Golez,Tan Hua,Thomas Bock

Ammar Ahmed,Jan Michael Golez,Tan Hua,Thomas Bock

Manual Summary Rollup
Manual Summary
Start-only
Finish-only
Deadline
Progress

Project: Gant Chart
Date: Wed 2/24/16
