TBock3185/CraftCube/First Semester/Week 5/Panel Drawing v2.pdf

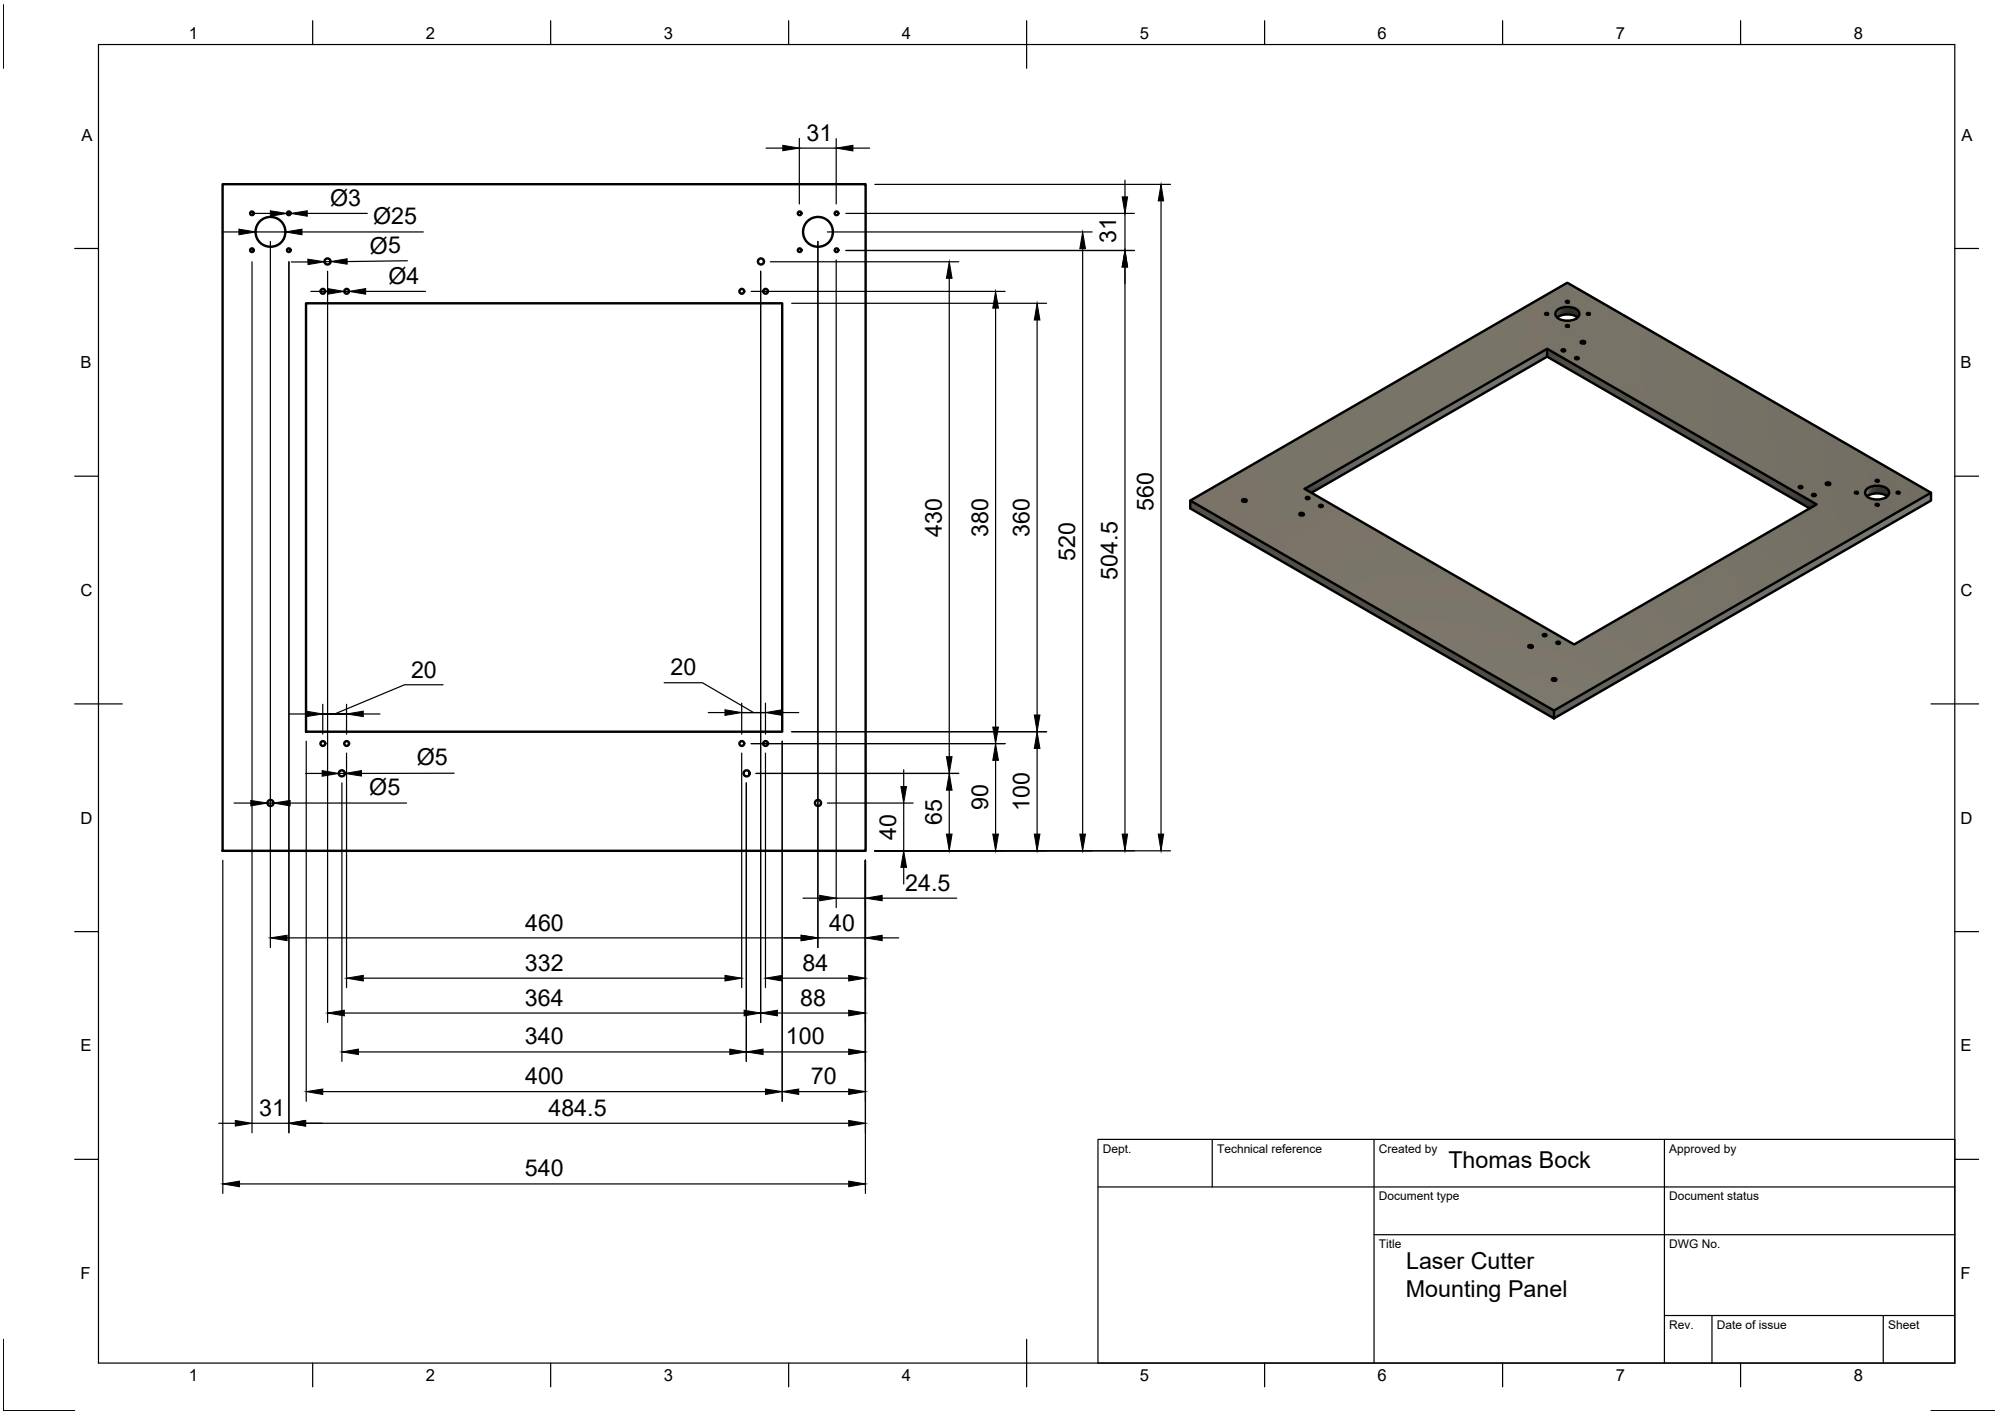
[picture p188: page 1]

Dept. | Technical reference | Created by Thomas Bock | Approved by

Document type | Document status

Title Laser Cutter Mounting Panel | DWG No.

Rev. | Date of issue | Sheet
