TBock3185/CraftCube/First Semester/Final presentation/Charts-Diagram/FlowChart_FinalPresentation.pdf

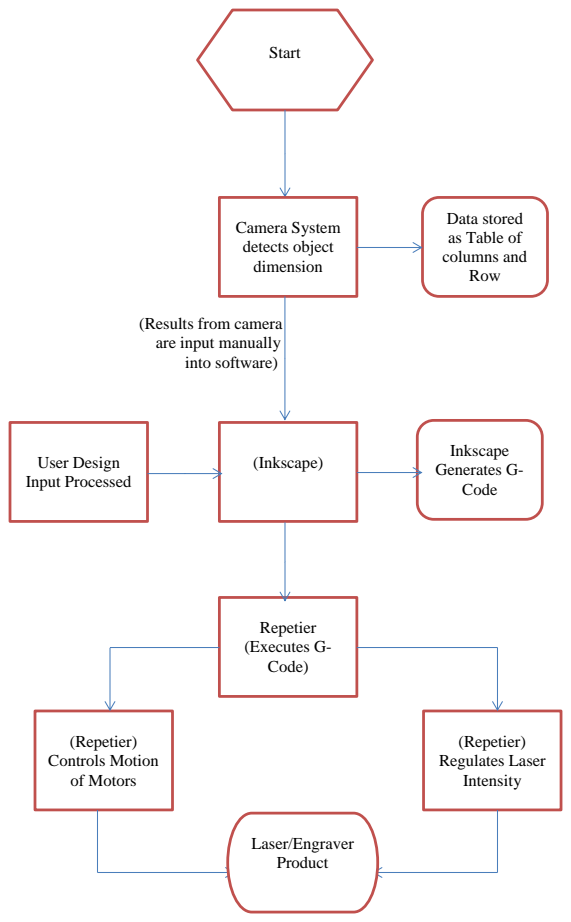
[picture p189: page 1]
Start; Camera System detects object dimension; User Design; (Inkscape); Input Processed; Inkscape Generates G- Code; Repetier (Executes G- Code); (Repetier) Regulates Laser Intensity; (Repetier) Controls Motion of Motors; Laser/Engraver Product

Data stored
as Table of
columns and
Row

(Results from camera
are input manually
into software)
