TBock3185/CraftCube/Second Semester/193B Final Poster Draft/Final Poster Draft_3 (1).pdf

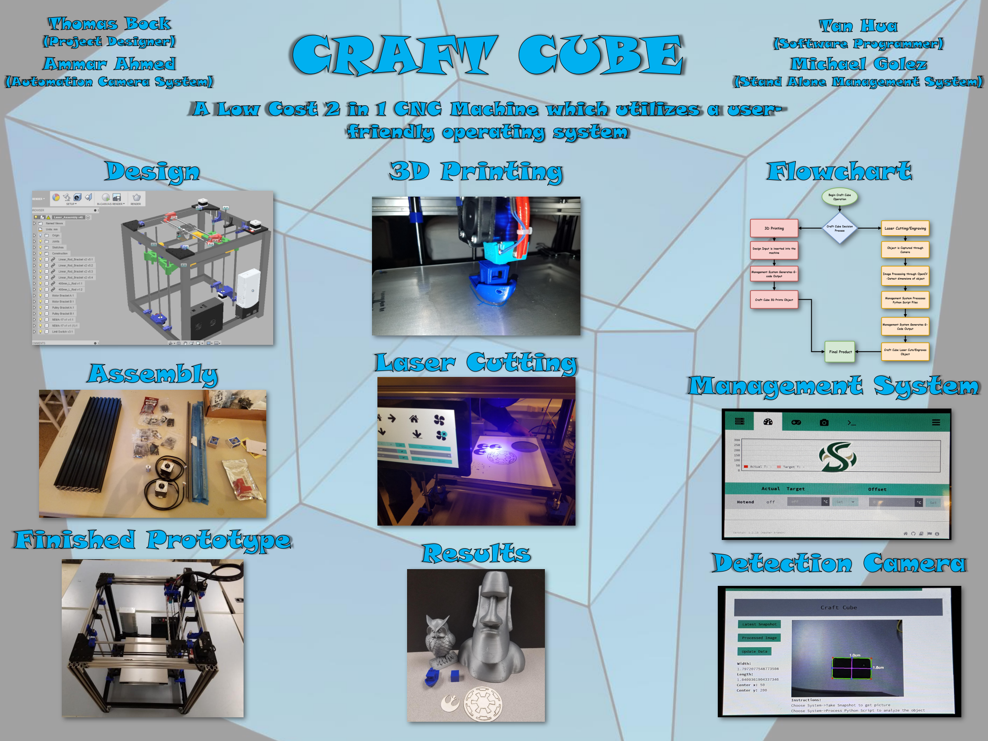
[picture p190: page 1]
