TBock3185/CraftCube/(commit log)

2017-01-30 Upload of Week 3
    [Parts.xlsx]
2017-01-30 Upload of Forms/Syllabus
    [Availability time sheet.xlsx, Book1.xlsx]
2017-02-02 Restructure 1
    [Parts.xlsx]
2017-02-02 Restructure 4
    [Availability time sheet.xlsx, Book1.xlsx]
2017-02-02 Upload of Second Semester 2
    [16 Sp 190 193 Peer Evaluations.xls, Availability time sheet.xlsx.xlsx]
2017-02-03 Upload of IGES assembly
2017-02-03 Readme for CAD Files
